fogslin/music-glasses/shots/docs_wiring.png

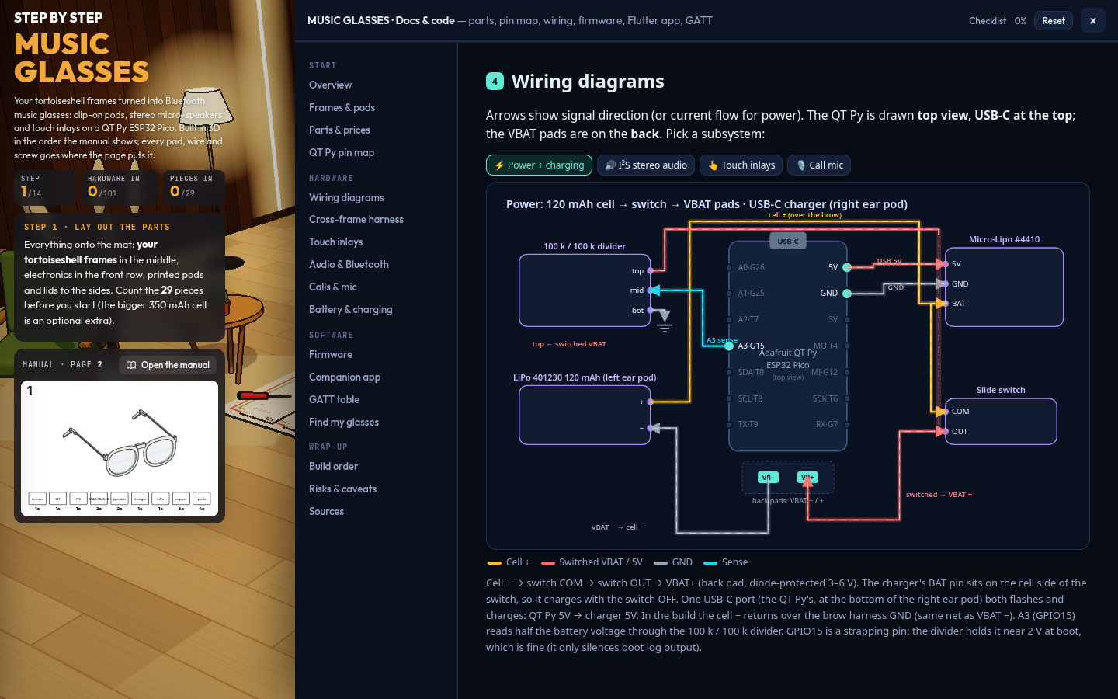
shots/docs_wiring.png
