fogslin/music-glasses/shots/20_soldering.png

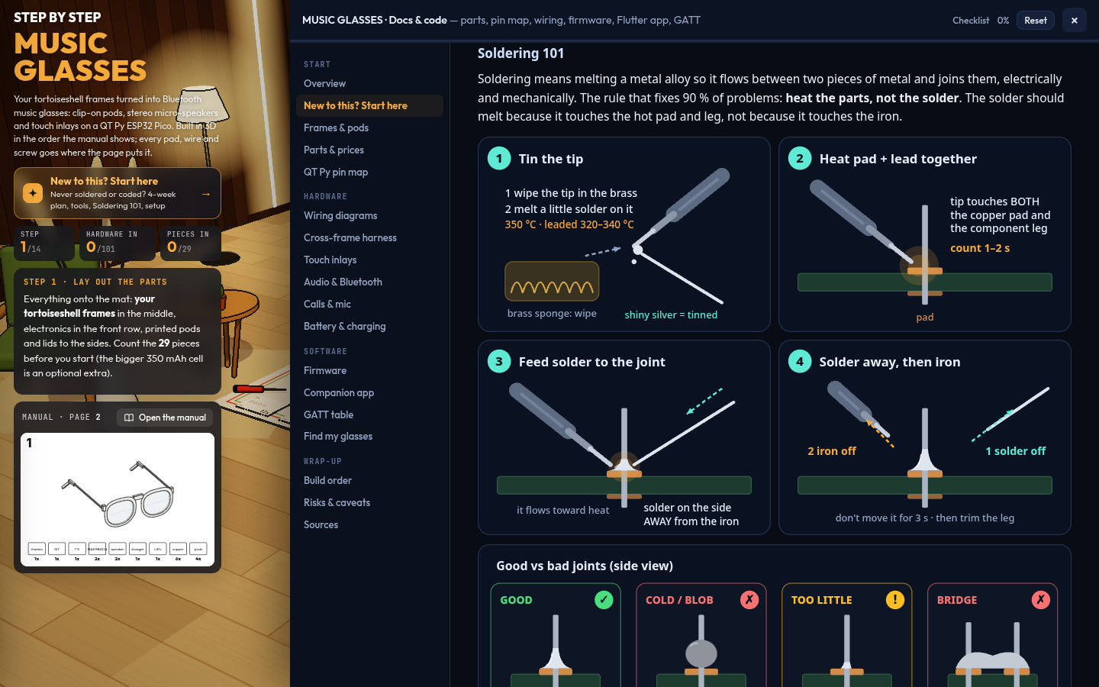
shots/20_soldering.png
