fogslin/music-glasses/shots/01_frames_prep.png

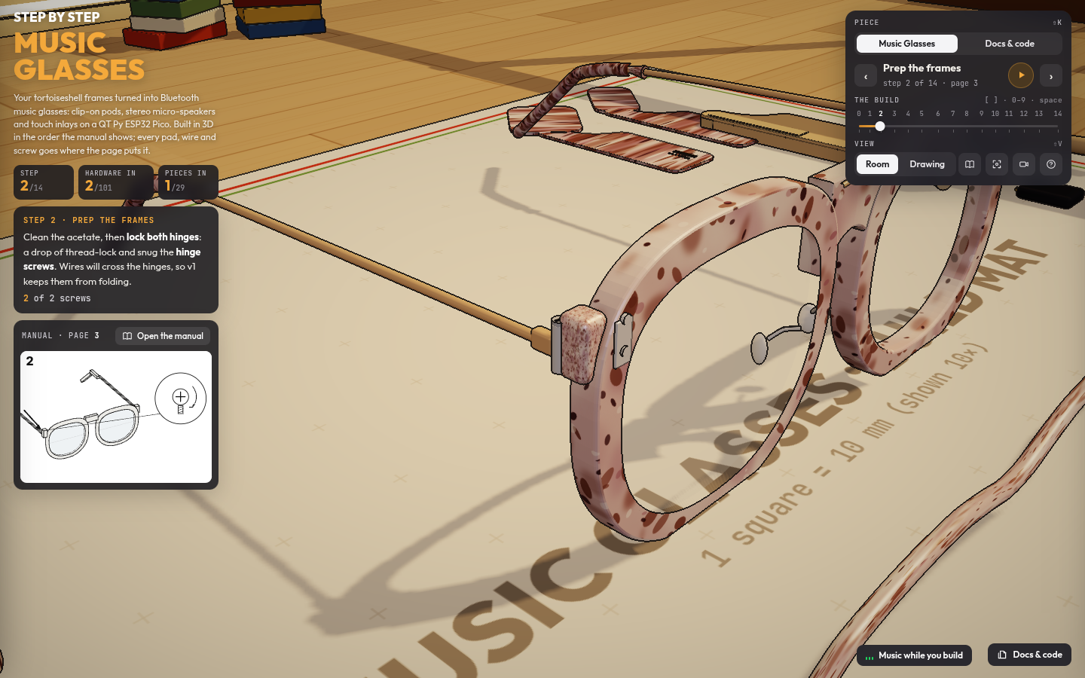
shots/01_frames_prep.png
