fogslin/music-glasses/shots/02_pods_clip.png

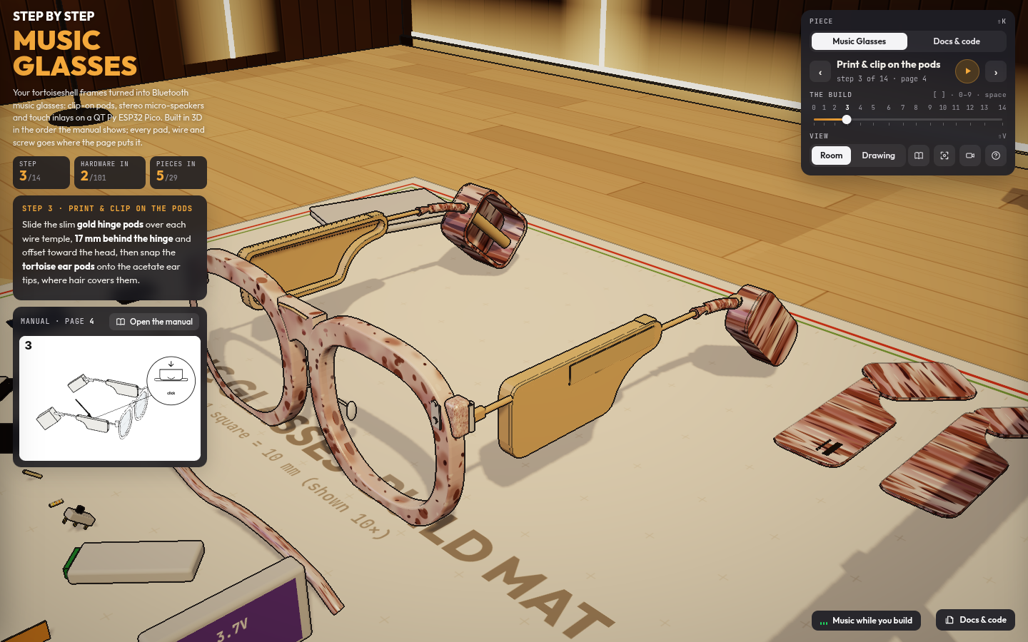
shots/02_pods_clip.png
