fogslin/music-glasses/shots/03_mcu.png

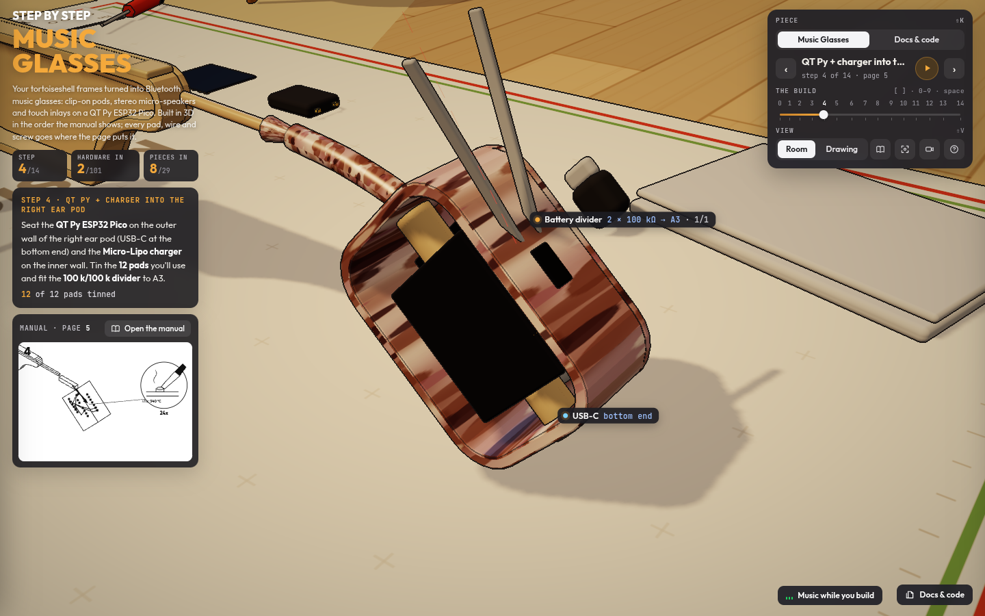
shots/03_mcu.png
