fogslin/music-glasses/shots/04_audio.png

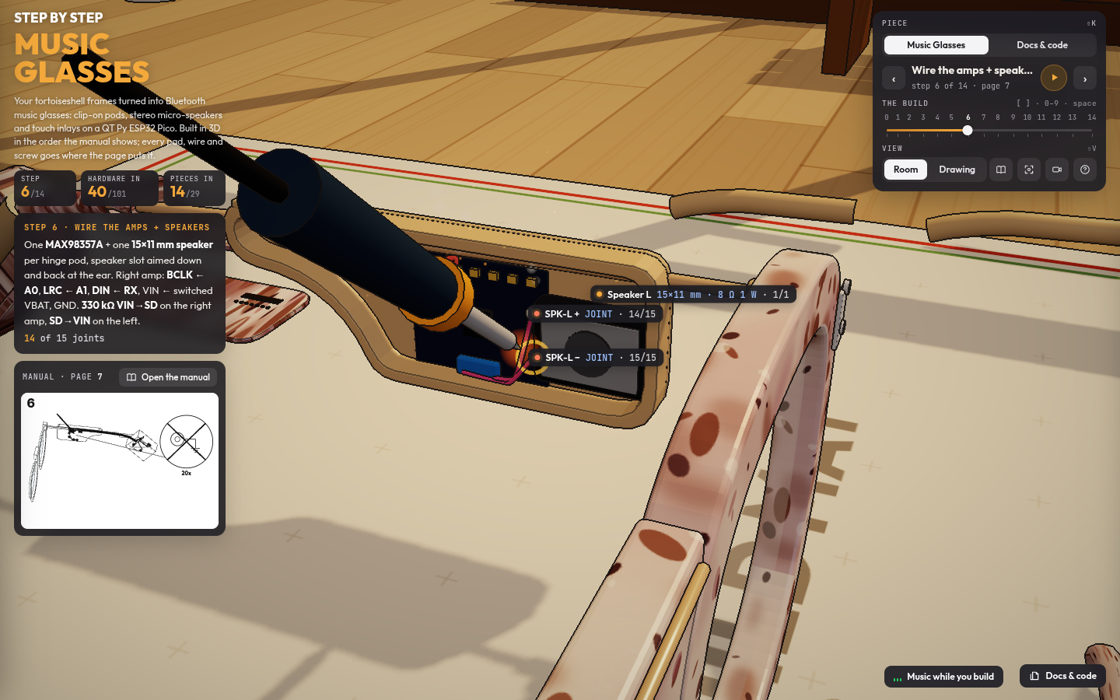
shots/04_audio.png
