fogslin/music-glasses/shots/05_touch.png

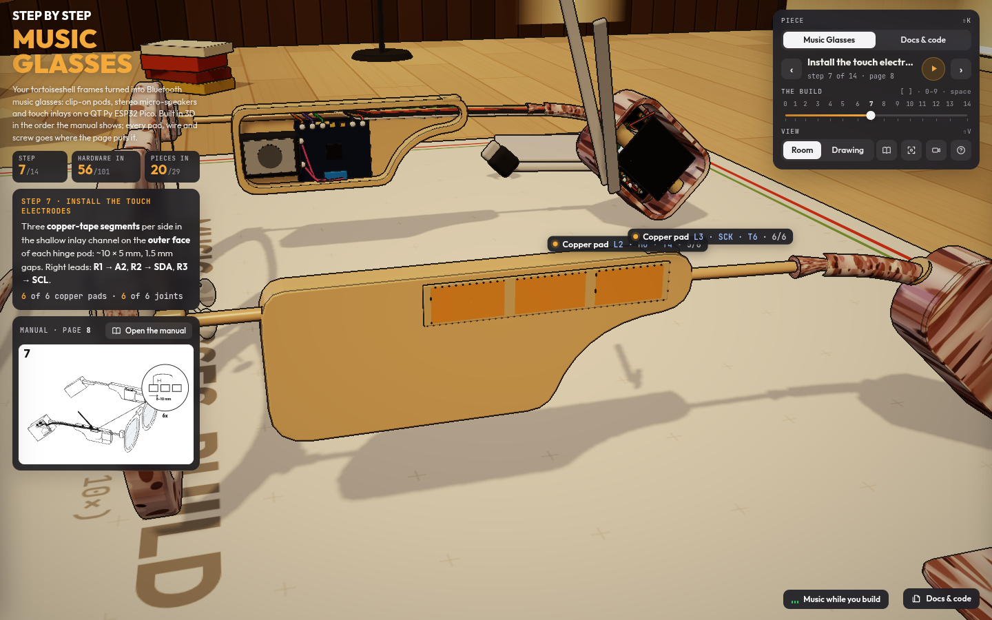
shots/05_touch.png
