fogslin/music-glasses/shots/06_brow.png

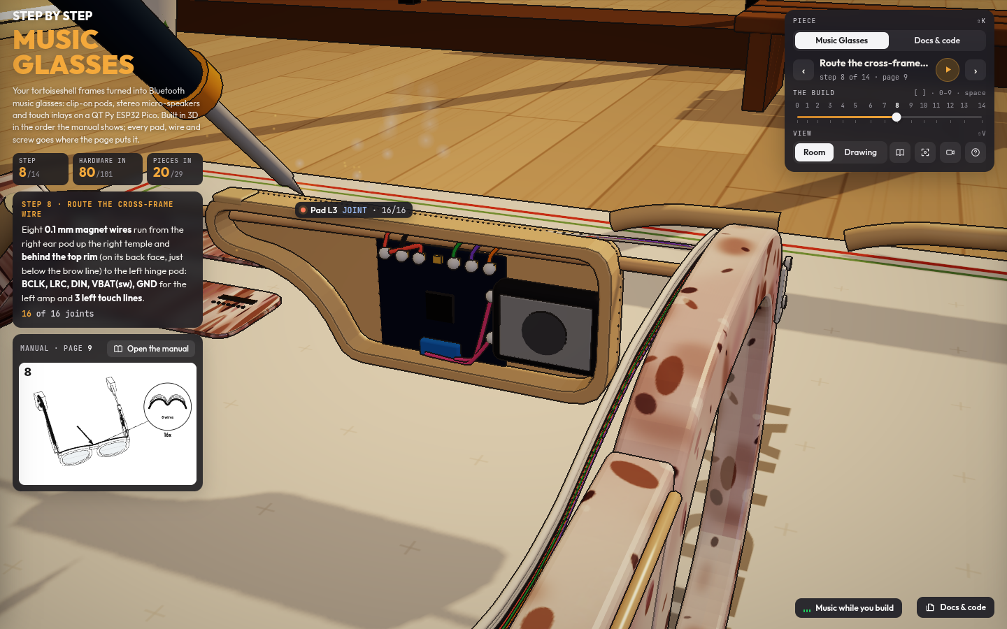
shots/06_brow.png
