fogslin/music-glasses/shots/08_close.png

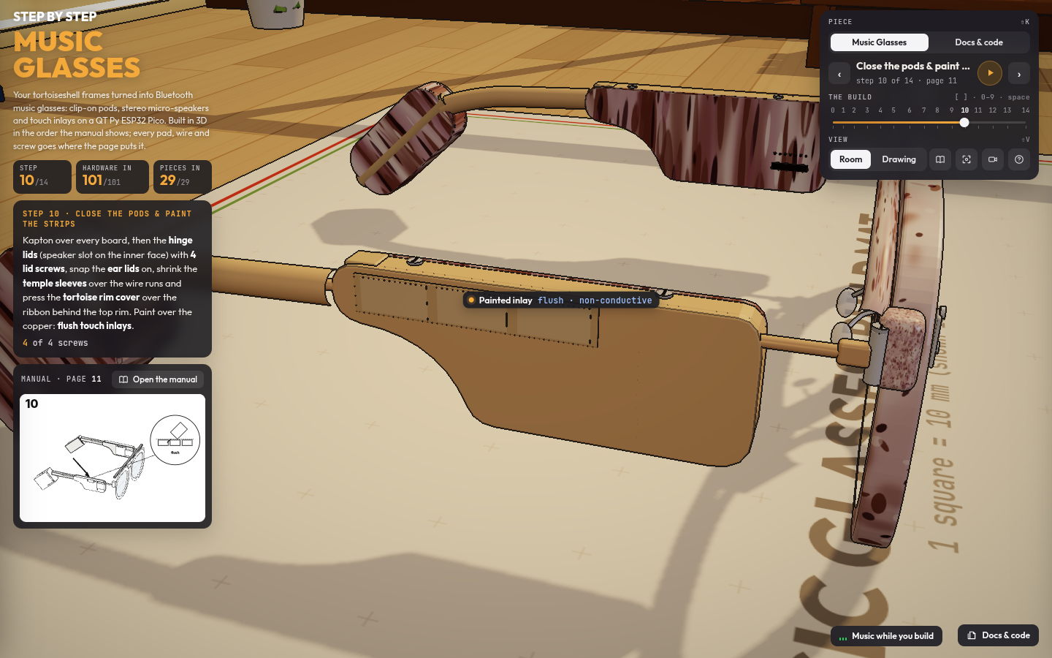
shots/08_close.png
