fogslin/music-glasses/shots/09_flash.png

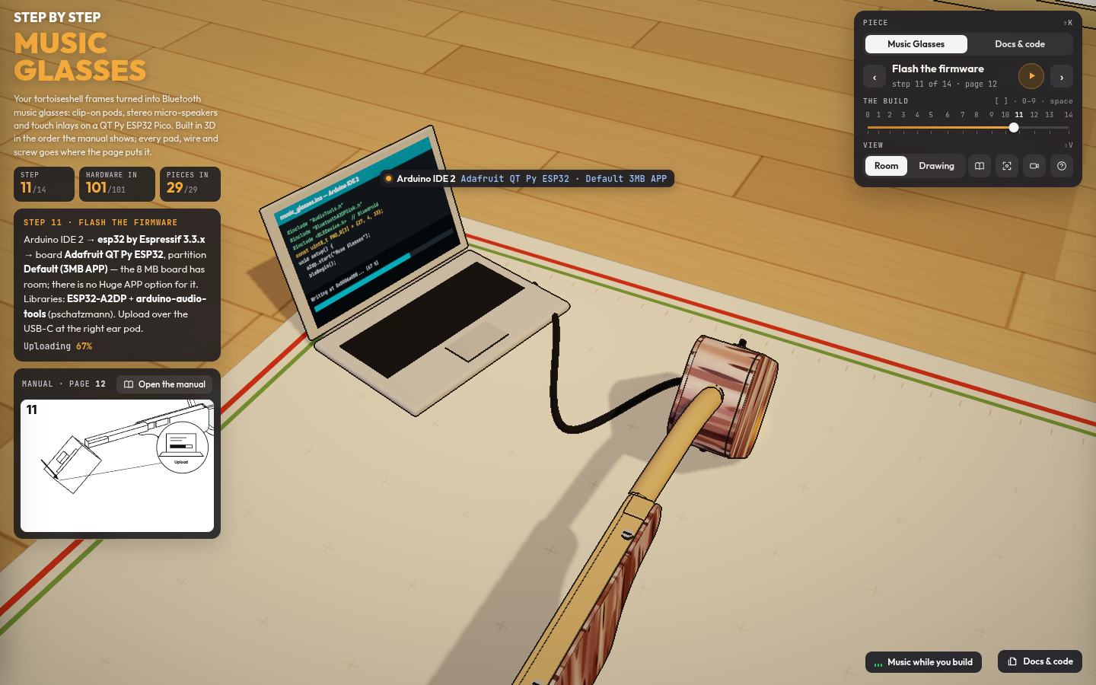
shots/09_flash.png
