fogslin/music-glasses/shots/10_pair_music.png

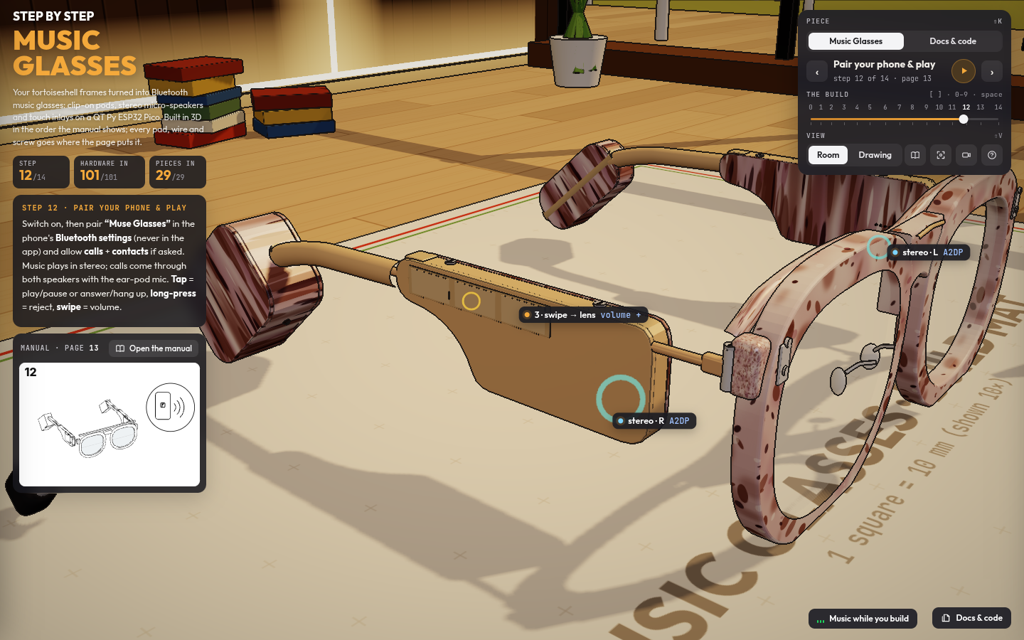
shots/10_pair_music.png
