fogslin/music-glasses/shots/11_app.png

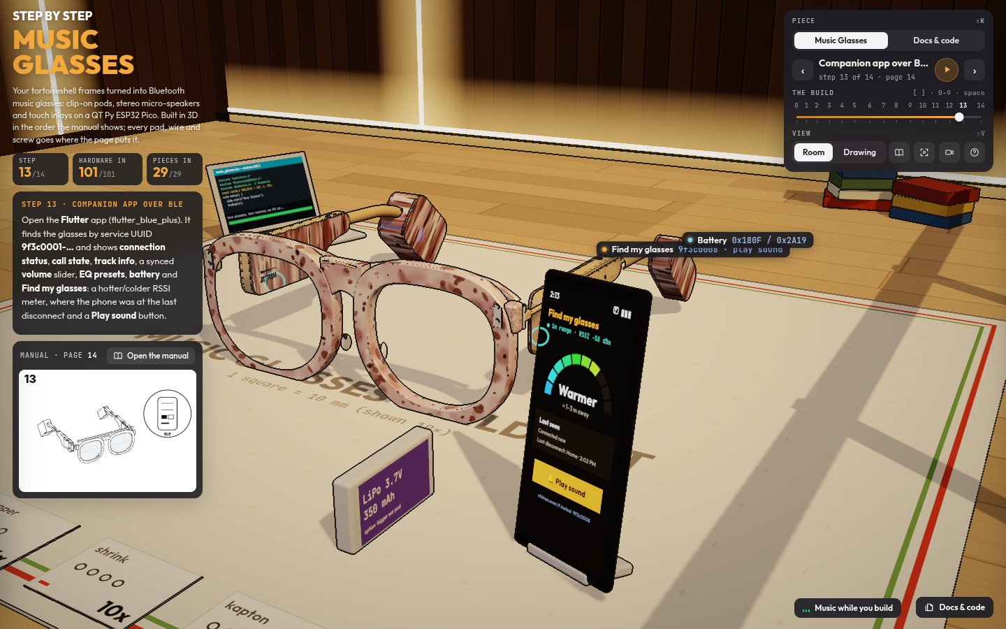
shots/11_app.png
