fogslin/music-glasses/shots/12_final.png

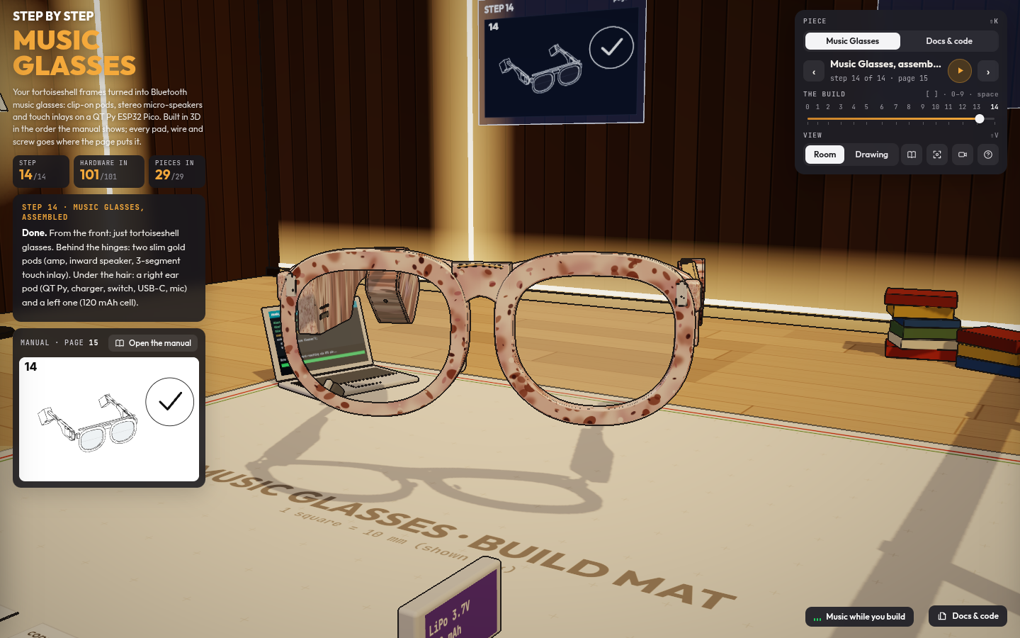
shots/12_final.png
