fogslin/music-glasses/shots/12b_final_turn.png

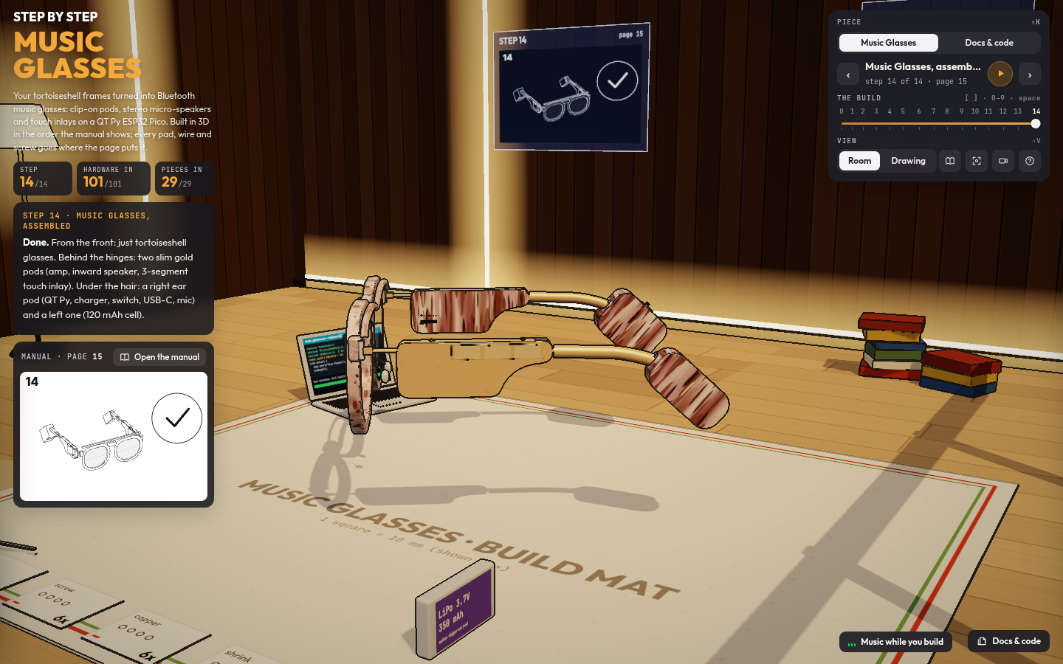
shots/12b_final_turn.png
