fogslin/music-glasses/shots/13_layout.png

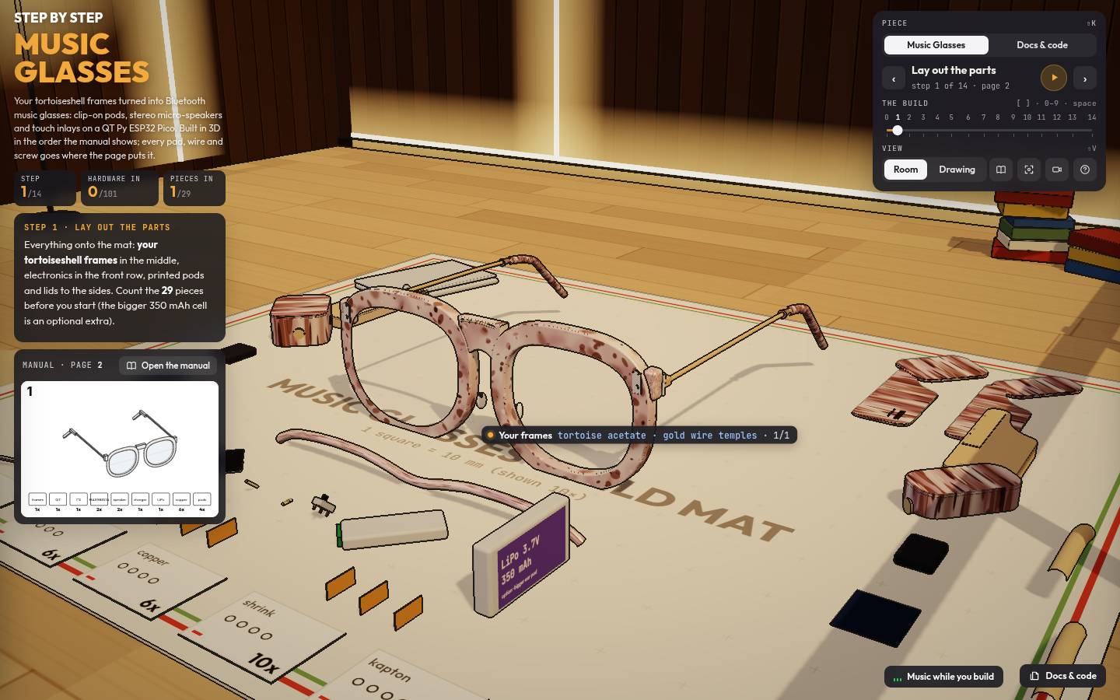
shots/13_layout.png
