fogslin/music-glasses/shots/14_touch_drawing.png

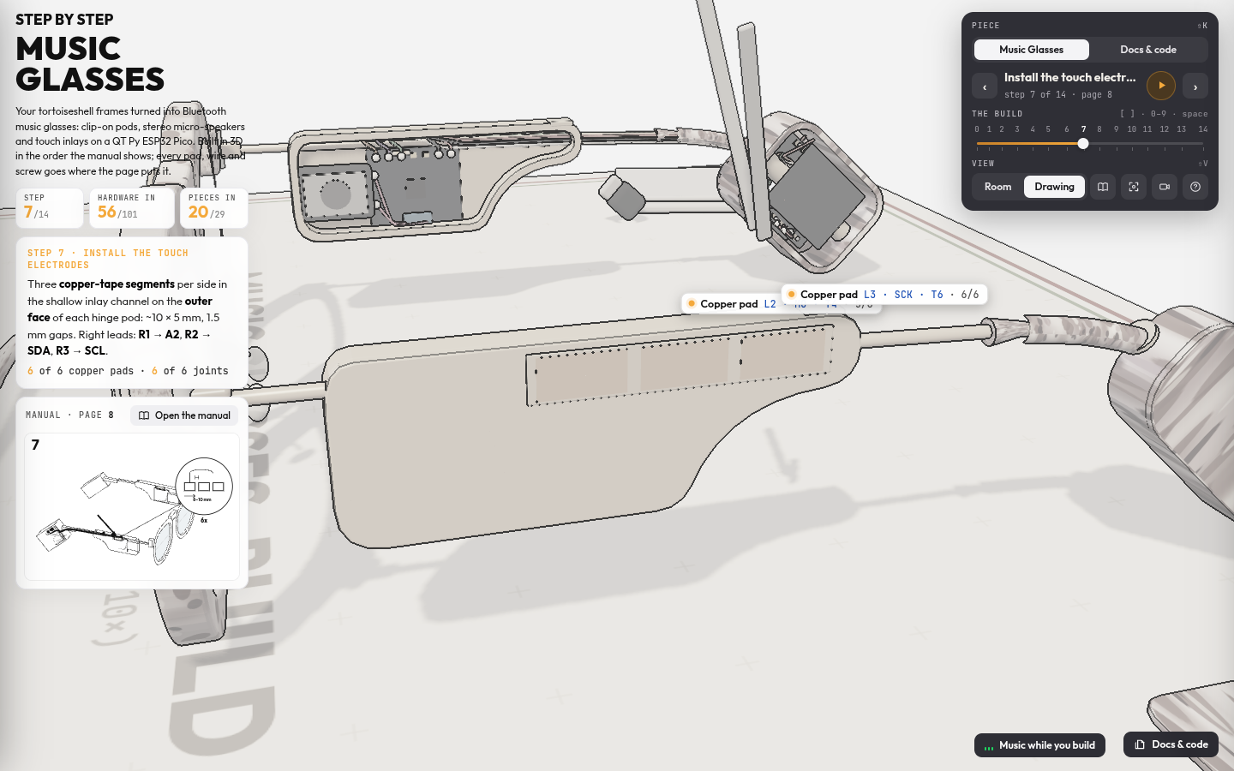
shots/14_touch_drawing.png
