fogslin/music-glasses/shots/15_music_panel.png

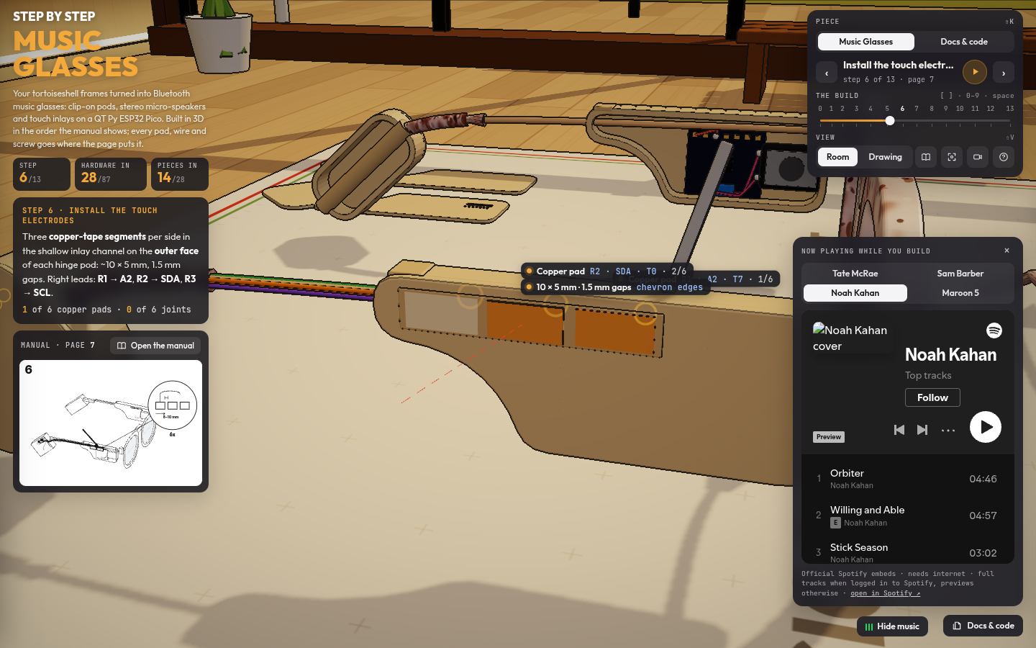
shots/15_music_panel.png
