fogslin/music-glasses/shots/16_mic.png

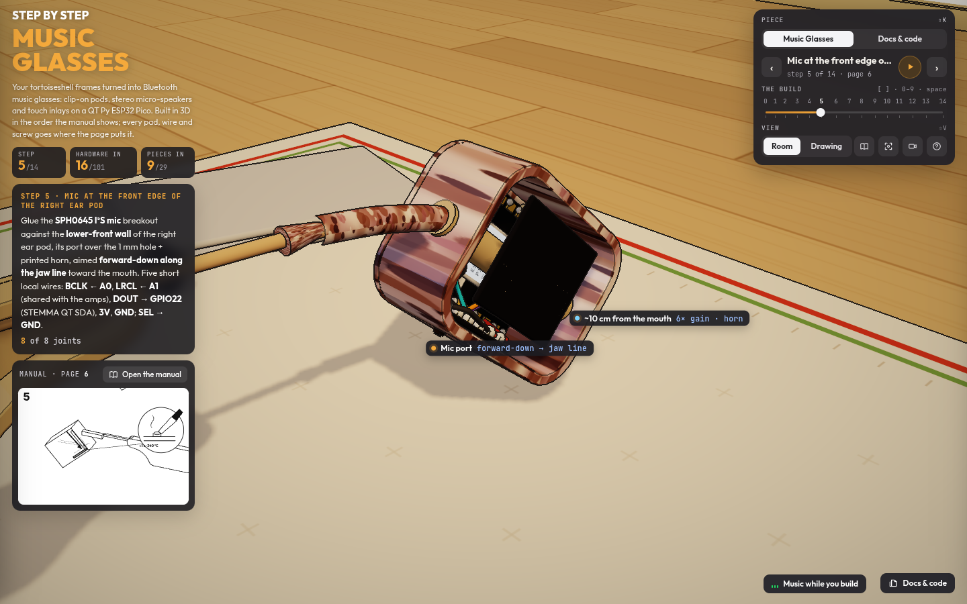
shots/16_mic.png
