fogslin/music-glasses/shots/17_find.png

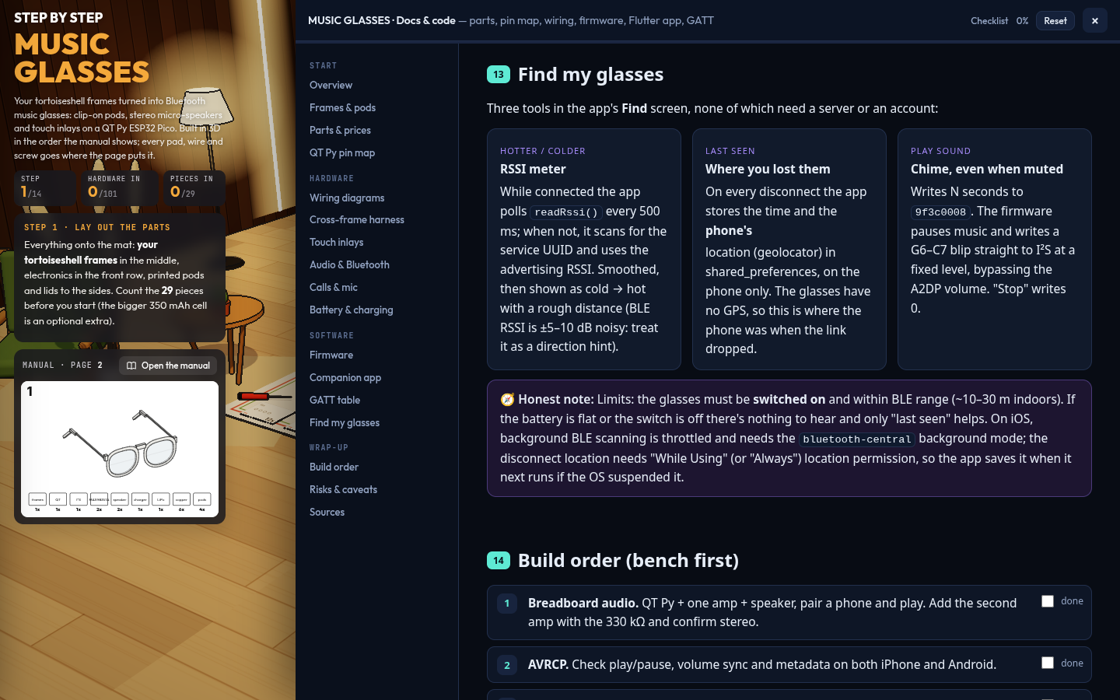
shots/17_find.png
