fogslin/music-glasses/shots/18_front_inconspicuous.png

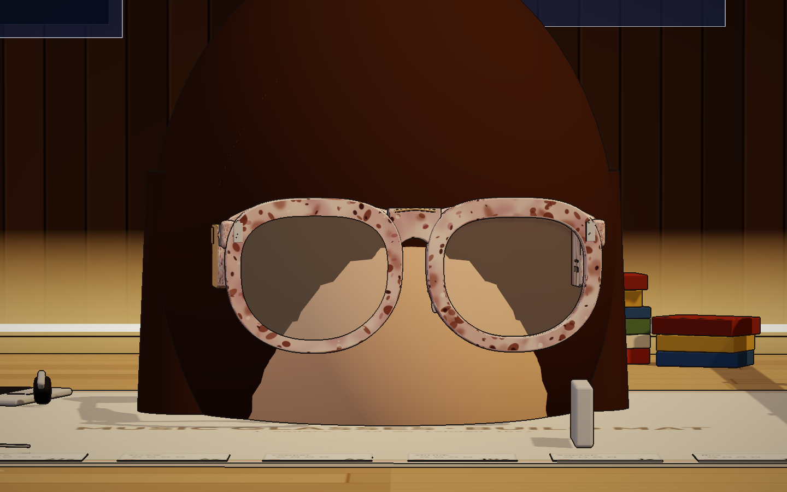
shots/18_front_inconspicuous.png
