fogslin/music-glasses/shots/19_beginner.png

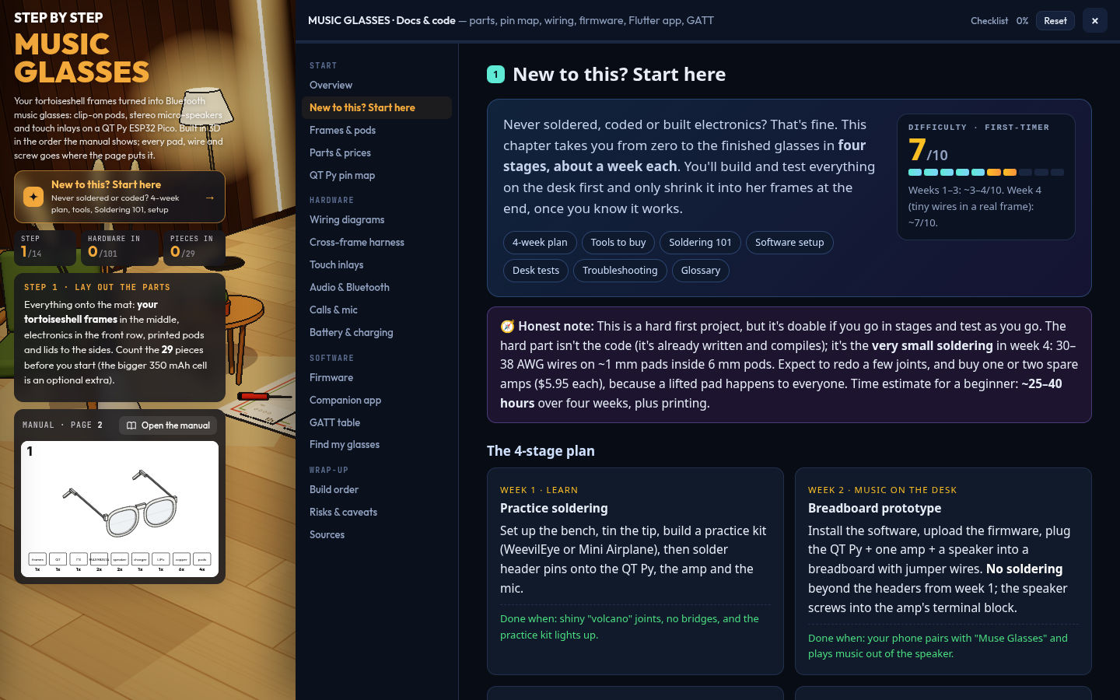
shots/19_beginner.png
