fogslin/music-glasses/build-guide.html

LOADING THE ROOM…

STEP BY STEP

# MUSIC GLASSES

Your tortoiseshell frames turned into Bluetooth music glasses: clip-on pods, stereo micro-speakers and touch inlays on a QT Py ESP32 Pico. Built in 3D in the order the manual shows; every pad, wire and screw goes where the page puts it.

✦New to this? Start hereNever soldered or coded? 4-week plan, tools, Soldering 101, setup→

Step1/13

Hardware in0/0

Pieces in0/0

▾

STEP 1

MANUAL · PAGE 2 Open the manual

PIECE⇧K

Music GlassesDocs & code

‹

…

›

THE BUILD[ ] · 0–9 · space

VIEW⇧V

RoomDrawing

× How it works
The build plays on its own, step after step. Scrub THE BUILD timeline or click a number to jump.
← → / [ ] step · space play/pause · 1–9 jump · M manual · ⇧V Room/Drawing · ⇧K Docs
Drag the scene to look around (free camera); the camera icon toggles it, the frame icon returns to the director.

NOW PLAYING WHILE YOU BUILD×

Official Spotify embeds · needs internet · full tracks when logged in to Spotify, previews otherwise · open in Spotify ↗

Music while you build

Docs & code

MUSIC GLASSES · ASSEMBLY MANUALStep-by-step pages

follow the build ×

‹1 / 1›

MUSIC GLASSES · Docs & code — parts, pin map, wiring, firmware, Flutter app, GATT

Checklist 0%Reset×

Build guide · v1 prototype · from the "Music Glasses v1 Prototype" spec

# Music Glasses Mark 1 — music and calls in your own tortoiseshell frames

Rounded-square tortoiseshell acetate frames that look completely normal from the front. Two slim gold hinge pods sit 17 mm back on the wire temples, each holding a MAX98357A I²S amp, a 15 × 11 mm micro-speaker on the inner face and three flush touch inlays. Two tortoise ear pods ride on the acetate ear tips, under the hair: the right one carries an Adafruit QT Py ESP32 Pico (classic Bluetooth A2DP + HFP + BLE), the USB-C charger, the power switch and an SPH0645 I²S mic at its front edge, aimed down the jaw line; the left one carries a 120 mAh cell. A Flutter app talks to the glasses over BLE and helps you find them.

1 · MusicBluetooth musicA2DP sink "Muse Glasses" + AVRCP: stereo from your phone, one amp + speaker per side.

2 · CallsPhone callsHands-Free Profile (HFP 1.7 client): CVSD 8 kHz or mSBC 16 kHz wideband, mic in the right ear pod.

3 · TouchTap · long-press · swipeTap = play/pause or answer/hang up. Long-press = reject. Swipe = volume (call volume in a call).

4 · AppCompanion appFlutter + flutter_blue_plus: now playing, call state, volume, EQ, battery, settings.

5 · FindFind my glassesHotter/colder RSSI meter, where your phone was at the last disconnect, and a Play-sound chime that ignores mute.

6 · DiscreetInvisible from the frontNothing on the frame front; the cross-frame wire hides behind the top rim; the electronics hide under the hair.

Never soldered, coded or built electronics? Start with New to this? Start here: a 4-week plan, the tools to buy, Soldering 101, software setup from zero and desk tests for every stage.

Hobby prototype. Estimates: ~1 hour of music or ~45–60 min of calls from the 120 mAh cell (~3× with the 350 mAh option). Open-ear sound leaks a little. The mic sits ~10 cm from the mouth (behind the ear, for looks), so callers hear you a bit quieter and with more room sound than on earbuds. The firmware compiles but has not been run on hardware yet.

## 1 New to this? Start here

Never soldered, coded or built electronics? That's fine. This chapter takes you from zero to the finished glasses in four stages, about a week each. You'll build and test everything on the desk first and only shrink it into her frames at the end, once you know it works.

4-week planTools to buySoldering 101Software setupDesk testsTroubleshootingGlossary

DIFFICULTY · FIRST-TIMER

7/10

Weeks 1–3: ~3–4/10. Week 4 (tiny wires in a real frame): ~7/10.

This is a hard first project, but it's doable if you go in stages and test as you go. The hard part isn't the code (it's already written and compiles); it's the very small soldering in week 4: 30–38 AWG wires on ~1 mm pads inside 6 mm pods. Expect to redo a few joints, and buy one or two spare amps ($5.95 each), because a lifted pad happens to everyone. Time estimate for a beginner: ~25–40 hours over four weeks, plus printing.

### The 4-stage plan

Week 1 · LearnPractice solderingSet up the bench, tin the tip, build a practice kit (WeevilEye or Mini Airplane), then solder header pins onto the QT Py, the amp and the mic.

Done when: shiny "volcano" joints, no bridges, and the practice kit lights up.

Week 2 · Music on the deskBreadboard prototypeInstall the software, upload the firmware, plug the QT Py + one amp + a speaker into a breadboard with jumper wires. No soldering beyond the headers from week 1; the speaker screws into the amp's terminal block.

Done when: your phone pairs with "Muse Glasses" and plays music out of the speaker.

Week 3 · Touch & callsStill on the deskAdd three foil/copper-tape touch pads on jumper wires (tap = play/pause, swipe = volume), then the SPH0645 mic (its data wire uses the solderless STEMMA QT cable) and make a real phone call.

Done when: tap pauses, swipe changes volume, a caller can hear you and you can hear them.

Week 4 · ShrinkInto her framesPrint the pods, practise magnet wire on scrap, then follow the 14 animated steps of this guide: amps + speakers in the hinge pods, the hidden harness behind the top rim, touch inlays, then the battery last.

Done when: everything from weeks 2–3 still works with the battery, and nothing shows from the front.

### Tools shopping list

Prices checked Oct 26, 2026 (ET); every link loaded (HTTP 200) that day. USD before tax and shipping; "~" means an estimate. Stock changes daily. These are tools; the glasses' own electronics are in Parts & prices. Essentials ≈ $198, or ≈ $163 if you already own a 45 W+ USB-C laptop charger and cable.

Tool · why | Pick | Price | Link
needSoldering iron, temperature-controlled Melts solder. Temperature control matters: too hot lifts tiny pads, too cold makes dull joints. | Pinecil V2 (USB-C, 12–20 V PD). Comes with a general-purpose tip. | $25.99 | PINE64 store (https://pine64.com/product/pinecil-smart-mini-portable-soldering-iron/) · US stock: SparkFun $68.50 (https://www.sparkfun.com/pinecil-smart-mini-portable-soldering-iron.html)
needUSB-C PD power supply, 45 W+ (65 W best) The Pinecil needs USB-C Power Delivery at 12–20 V, 3 A. A phone charger isn't enough; a 45 W+ laptop charger is fine. | PinePower 65 W GaN charger (skip it if you own a 45 W+ USB-C laptop charger) | $24.99 | PINE64 store (https://pine64.com/product/pinepower-65w-gan-2c1a-charger-with-international-plugs/)
needUSB-C to USB-C cable (5 A, e-marked) Carries the power from the charger to the Pinecil. | Adafruit USB-C to USB-C cable, 1 m | $9.95 | Adafruit #4199 (https://www.adafruit.com/product/4199)
niceFine tips for the iron A fine conical tip makes 30–38 AWG wires and 1 mm pads (week 4) much easier. | Pinecil fine tip set (TS-BC2, TS-C1, TS-ILS, TS-KU) | $24.99 | PINE64 store (https://pine64.com/product/pinecil-soldering-tip-set-fine/)
needSolder, rosin-core, 0.5 mm Thin solder is easier to dose on small joints. Leaded 60/40 melts lower and flows more easily (best for learning); lead-free is the alternative. | 60/40 rosin core 0.5 mm, 50 g | $9.25 | Adafruit #1886 (https://www.adafruit.com/product/1886) · lead-free SAC305: #1930 $27.50 (https://www.adafruit.com/product/1930)
needFlux pen Cleans the metal while you solder so the solder flows. The #1 fix for blobs. | Chip Quik no-clean flux pen CQ4LF, 10 ml | $7.95 | Adafruit #3468 (https://www.adafruit.com/product/3468) · SparkFun $8.50 (https://www.sparkfun.com/chip-quik-no-clean-flux-pen-10ml.html)
needBrass tip cleaner Wipes old solder off the tip without cooling it (better than a wet sponge). | Hakko brass sponge | $10.95 | Adafruit #1172 (https://www.adafruit.com/product/1172) · SparkFun $10.95 (https://www.sparkfun.com/brass-sponge.html)
needIron stand Somewhere safe to put a 350 °C iron down. The Pinecil has no stand of its own. | SparkFun soldering iron stand | $7.75 | SparkFun (https://www.sparkfun.com/soldering-iron-stand.html)
needHelping hands / PCB holder Holds the board or wire so both your hands are free (one for the iron, one for the solder). | Helping third hand with magnifier | $6.95 | Adafruit #291 (https://www.adafruit.com/product/291) · sturdier: PCB holder SN-390 $19.95 (https://www.adafruit.com/product/3791)
needFlush cutters Snip component legs and wires flat. | Flush diagonal cutters CHP170 | $7.25 | Adafruit #152 (https://www.adafruit.com/product/152)
needWire strippers down to 30 AWG Strips the thin silicone wire without cutting the strands. | Hakko CSP-30-1 (20–30 AWG) | $17.50 | Adafruit #527 (https://www.adafruit.com/product/527)
needFine tweezers Hold tiny wires and parts in place (fingers get burned). | Fine-tip curved tweezers, ESD-safe | $3.95 | Adafruit #422 (https://www.adafruit.com/product/422)
needMultimeter Beeps when two points are connected (continuity), measures battery voltage, finds shorts. | SparkFun Digital Multimeter – Basic | $21.50 | SparkFun (https://www.sparkfun.com/digital-multimeter-basic.html) · Adafruit 9205B+ #2034 $17.50 (https://www.adafruit.com/product/2034) out of stock Oct 26
needBreadboard Push-in prototyping board: build the circuit on the desk with no soldering. | Full-size breadboard, 830 points | $5.95 | Adafruit #239 (https://www.adafruit.com/product/239)
needJumper wires (male/male) Plug-in wires for the breadboard. | Premium M/M jumpers, 40 × 150 mm | $3.95 | Adafruit #758 (https://www.adafruit.com/product/758)
needHeader pins Spare pin strips (the QT Py ships without headers; the amp and mic come with a short piece). | 36-pin male header strips, 10 pack | $4.95 | Adafruit #392 (https://www.adafruit.com/product/392)
needSTEMMA QT → male jumper cable Reaches the mic data pin (GPIO22 on the QT Py's little connector) with no soldering. | STEMMA QT / Qwiic to male headers, 150 mm | $0.95 | Adafruit #4209 (https://www.adafruit.com/product/4209)
needUSB data cable for the QT Py Many cheap cables only charge. This one carries data. (The C-to-C cable above also works if your computer has USB-C.) | USB-A to USB-C, 1 m | $4.95 | Adafruit #4474 (https://www.adafruit.com/product/4474)
needBeginner practice kit ($10–20) Through-hole practice before you touch the real parts. Pick one. | SparkFun WeevilEye (10–20 min build) | $9.95 | SparkFun (https://www.sparkfun.com/sparkfun-weevileye-beginner-soldering-kit.html) · Mini Airplane kit $14.95 (https://www.sparkfun.com/mini-airplane-soldering-kit-red.html)
needSafety glasses Clipped legs and solder spatter fly. Always wear them. | SparkFun safety glasses | $5.10 | SparkFun (https://www.sparkfun.com/sparkfun-safety-glasses.html)
needSolder wick (desoldering braid) Soaks up solder to fix bridges and mistakes. | Solder wick, 0.8 mm × 1.5 m | $2.95 | Adafruit #4456 (https://www.adafruit.com/product/4456) · 1.5 mm: #149 $3.50 (https://www.adafruit.com/product/149)
needKapton (polyimide) tape Heat-proof insulating tape: covers joints and protects the frame near the iron. | Polyimide tape, 1 cm × 33 m | $4.95 | Adafruit #3057 (https://www.adafruit.com/product/3057)
needFume extraction / ventilation Rosin smoke irritates eyes and lungs. Work by an open window with a small fan pulling the smoke away from your face (not blowing it at you). | Window + any small desk fan | ~$0–20 (estimate) | no link: use what you have · bench extractor: Hakko FA-400 $81.67 (https://hakkousa.com/products/fume-extraction.html)
niceDesk test speaker A bigger, louder speaker for the week 2 breadboard (the tiny glasses speakers work too). | Speaker 3", 4 Ω 3 W | $1.95 | Adafruit #1314 (https://www.adafruit.com/product/1314)

The Pinecil from the PINE64 store ships from overseas (slow). SparkFun's listing is pricier but ships from the US. Any temperature-controlled iron with a fine tip works, e.g. the ATTEN ST-2065D, $37.50 (https://www.adafruit.com/product/4695) out of stock Oct 26.

### Soldering 101

Soldering means melting a metal alloy so it flows between two pieces of metal and joins them, electrically and mechanically. The rule that fixes 90 % of problems: heat the parts, not the solder. The solder should melt because it touches the hot pad and leg, not because it touches the iron.

1. Set up. Safety glasses on, window open, fan pulling the smoke away. Iron in its stand, brass cleaner next to it. Set 330 °C for leaded solder (350–370 °C for lead-free).
2. Tin the tip (fig. 1). Wipe it in the brass, then melt a little solder onto it. A shiny tip moves heat; a black, dull one doesn't. Re-tin before you put the iron back in the stand.
3. Make a joint (figs. 2–4). Touch the tip to the pad and the leg for 1–2 s, feed solder into the far side of the joint until it forms a small cone, take the solder away, then the iron. 2–4 s in total. Don't blow on it or move it while it sets.
4. Practice kit. Build the WeevilEye or Mini Airplane. Compare every joint with the good-vs-bad picture, fix the bad ones with flux + reheat or wick (fig. 8).
5. Headers on the real boards. Push the header strip into the breadboard (long pins down), drop the QT Py on top, solder one corner pin, check it's straight, then do the rest. Same for the amp's and the mic's headers. The breadboard keeps the pins straight.
6. Thin wire (figs. 5–6). Strip 2–3 mm of 30 AWG, twist, flux, tin. Tin the pad, lay the wire on, hold it with tweezers, touch 1 s. Tug gently: a good joint doesn't move.
7. Magnet wire (fig. 7, week 4). Practise 10 times on scrap wire before the real harness. Burn the enamel off in a hot solder blob, or scrape it. Then beep it with the multimeter.

Safety. The tip is ~350 °C: always put the iron back in its stand, never on the desk, and never catch a falling iron. Run cool water over a burn for 10–20 min. Ventilate (the smoke is flux, not lead, but it irritates). Wash your hands after soldering and before eating, especially with leaded solder; don't eat or drink at the bench. LiPo batteries: never short the two leads (cut and insulate one wire at a time), never puncture, bend or squeeze the cell, never charge it unattended or above 4.2 V, use only a protected cell and the 100 mA charger, and don't charge while wearing. If a cell swells, gets hot or smells sweet, stop using it and put it on a non-flammable surface outdoors.

### Software setup from zero

The firmware is the program that runs on the QT Py. You'll install a free editor, teach it about ESP32 boards, add two libraries, then press Upload. It takes about 30–45 minutes the first time, mostly downloads.

1. Install Arduino IDE 2. Download it from arduino.cc/en/software (Windows, macOS or Linux) and open it.
2. Add the ESP32 boards URL. File → Preferences (macOS: Arduino IDE → Settings) → Additional boards manager URLs, paste: https://espressif.github.io/arduino-esp32/package_esp32_index.json → OK. (Espressif's install guide (https://docs.espressif.com/projects/arduino-esp32/en/latest/installing.html))
3. Install the esp32 core. Tools → Board → Boards Manager, search esp32, pick esp32 by Espressif Systems, choose version 3.3.x (tested: 3.3.12) and Install. It's a big download (~10 min).
4. Select the board. Tools → Board → esp32 → Adafruit QT Py ESP32 (that's the Pico). Leave Partition Scheme on the default (3 MB app). (Adafruit's setup page (https://learn.adafruit.com/adafruit-qt-py-esp32-pico/arduino-ide-setup))
5. Install the two libraries (GitHub zips). Download ESP32-A2DP v1.8.11 .zip (https://github.com/pschatzmann/ESP32-A2DP/archive/refs/tags/v1.8.11.zip) and arduino-audio-tools v1.2.6 .zip (https://github.com/pschatzmann/arduino-audio-tools/archive/refs/tags/v1.2.6.zip). In the IDE: Sketch → Include Library → Add .ZIP Library… and pick each zip in turn. Don't unzip them first.
6. Open the sketch. Unzip this project, then File → Open → firmware/music_glasses/music_glasses.ino (the folder name must match the file name, as it does here).
7. Plug in USB-C. Use a data cable. Tools → Port: pick the new entry (Windows COM3…, macOS /dev/cu.usbserial-…, cu.usbmodem… or cu.wchusbserial…, Linux /dev/ttyACM0 or ttyUSB0).
8. Upload. Click the → arrow. It compiles (1–3 min the first time), then shows Writing at 0x… percentages and Hard resetting via RTS pin…. Done.
9. Read the Serial Monitor. Tools → Serial Monitor, set 115200 baud, press the QT Py's RST button. You should see Muse Glasses ready, free heap ….

#### Common errors

What you see | Why | Fix
No port in Tools → Port, or it's greyed out | Charge-only USB cable, or a missing USB-serial driver. Recent QT Py ESP32 Picos use a WCH CH9102F chip (older ones a CP2102N). | Try a different cable that you know carries data. Install the WCH driver (Adafruit's CH9102 driver guide (https://learn.adafruit.com/how-to-install-drivers-for-wch-usb-to-serial-chips-ch9102f-ch9102)), then unplug/replug. Linux: add yourself to the dialout group and log out/in.
Failed to connect to ESP32: No serial data received / Wrong boot mode | The board didn't enter upload mode on its own. | Hold BOOT, tap RST, release BOOT, click Upload again. Press RST after it finishes.
BluetoothA2DPSink.h: No such file or directory or AudioTools.h: No such file… | Library missing or added wrongly. | Re-add the right zip with Add .ZIP Library… and restart the IDE. Check Sketch → Include Library lists ESP32-A2DP and audio-tools.
esp_hf_client_api.h not found / errors about esp_a2d_… | Wrong board or an old core. | Board must be an ESP32 one (Adafruit QT Py ESP32) on core 3.3.x, not "Arduino Uno".
Sketch too big | Partition scheme changed. | Tools → Partition Scheme → Default (3 MB app). The sketch is ~1.2 MB.
Serial Monitor shows gibberish | Wrong speed. | Set 115200 baud in the monitor's drop-down.
Port busy / access denied | Another program (or a second IDE window) holds the port. | Close other serial monitors, unplug/replug.

### Desk-test checkpoints

Test at every stage before you move on. Tick them off: progress is saved in this browser.

#### Week 1 · bench & practice

1. Iron heats to the set temperature in ~10–20 s on the PD charger (the Pinecil screen shows it). Solder melts instantly on the tinned tip.
2. Practice kit works (the LEDs light). All joints look like the GOOD picture.
3. Multimeter beeps when you touch the two probes together (continuity mode, the ))) symbol). Beep one header pin against its pad: beep. Against the next pin: silence (no bridge).

#### Week 2 · music on the breadboard

1. Upload works and the Serial Monitor says Muse Glasses ready, free heap … (the number should be well above 30000).
2. Wire it with the board unplugged: 5V→VIN, GND→GND, A0→BCLK, A1→LRC, RX→DIN; GAIN and SD unconnected; speaker into the + / − terminal block. Double-check 5V and GND before you plug in.
3. Pair. Phone → Bluetooth → Muse Glasses. Serial: A2DP connected, free heap ….
4. Hear music from the speaker, at a level that follows the phone's volume buttons. Play/pause on the phone works. Some hiss with no music is normal; crackle isn't (see troubleshooting).

#### Week 3 · touch, then mic + calls

Part | Wire on the breadboard | Notes
Touch pads R1 / R2 / R3 | A2 (GPIO27) · SDA (GPIO4) · SCL (GPIO33) → one jumper each → a 1 × 1 cm square of copper tape or foil, three in a row ~2 mm apart, on a piece of card | Front → rear. Don't let the squares touch each other. Press RST after wiring: the firmware measures the untouched pads at start-up.
SPH0645 mic (headers soldered) | 3V → mic 3V · GND → GND · A0 → BCLK · A1 → LRCL · SEL → GND · DOUT → the blue (SDA) wire of the STEMMA QT cable plugged into the QT Py's small connector (GPIO22) | The mic shares BCLK/LRC with the amp: two jumpers in the same breadboard row. Leave the cable's yellow (SCL) wire unconnected.

1. Tap any pad briefly (40–300 ms): music pauses / plays.
2. Swipe a finger across R3→R2→R1 (rear to front, toward the lens): volume up a step. The other way: down.
3. Call. Call your phone from another phone (or call a friend). Tap a pad to answer. Serial: HFP state … then SCO mSBC 16k (or CVSD 8k). You hear the caller from the speaker; they hear you when you talk near the mic.
4. Hang up with a tap; while it's ringing, a ≥ 0.8 s press rejects the call. After the call, music resumes.
5. Optional: the BLE app / nRF Connect sees the glasses' service (see GATT table).

#### Week 4 · in the frames

1. Dry fit the printed pods on her frames and check the front view in a mirror before any soldering.
2. Beep every harness wire end to end and against its neighbours before it goes behind the rim cover.
3. Test on USB first (no battery): pairing, both speakers, touch and a call, exactly like weeks 2–3.
4. Battery last. Check polarity with the meter (red + / black −), switch off, connect, insulate. Switch on: Serial shows the ready line; unplug USB and it keeps playing.

### Troubleshooting checklist

No soundPairs, but silent

- VIN on 5V (not 3V) and GND connected?
- BCLK/LRC/DIN not swapped (A0→BCLK, A1→LRC, RX→DIN)?
- SD not tied to GND (that shuts the amp down)?
- Speaker screws tight on bare wire, not on insulation?
- Phone volume up and "Muse Glasses" picked as the audio output?

BluetoothWon't show up / won't pair

- Serial shows the ready line? If not: re-upload, press RST.
- "Forget" old Muse Glasses on the phone and pair again.
- Only one phone at a time: switch Bluetooth off on the other.
- Keep the board within a few metres while testing.

NoiseCrackle, pops, dropouts

- Push the jumpers fully in; wiggle each one while music plays.
- Use a short USB cable straight into the computer or a wall charger, not a hub.
- Free heap in Serial under ~20000? See Audio & Bluetooth.

TouchRandom pauses or no response

- Press RST with your hands off the pads (it calibrates at start-up).
- Pads not touching each other, jumpers in the right pins (A2, SDA, SCL)?
- Laptop on battery vs charger changes readings: test both.

CallsThey can't hear you

- Mic SEL to GND, 3V (not 5V) to the mic.
- DOUT on the blue STEMMA QT wire (GPIO22).
- BCLK/LRCL shared with the amp's rows.
- Talk within ~10 cm; raise MIC_GAIN in the sketch if quiet.

BoardResets, hot parts, weird smells

- Unplug at once. Look for a solder bridge or a 5V-to-GND jumper.
- Beep 5V against GND with USB unplugged: it must not beep.
- Battery hot or puffy: stop, see the LiPo safety box above.

### Glossary, in plain words

GPIO

"General-purpose input/output": one of the QT Py's metal pins the program can switch on/off or read. GPIO27 = pin number 27 inside the chip (printed "A2" on the board).

Pad

A small copper spot on a board where you solder a wire or a pin.

Header pins

A strip of metal pins you solder onto a board so it can plug into a breadboard.

Breadboard

A plastic board full of holes connected in rows: push parts and jumper wires in, no solder.

Jumper wire

A short wire with a pin on each end, for breadboards.

Microcontroller · QT Py ESP32 Pico

A tiny computer on a chip that runs one program. Ours does the Bluetooth, reads the touch pads and sends sound to the amps.

Firmware · sketch

The program on the microcontroller. In Arduino a program is called a sketch (.ino file).

Library

Ready-made code someone else wrote (here: Bluetooth audio) that our sketch uses.

Core / board package

The add-on that teaches the Arduino IDE how to build programs for ESP32 chips.

Serial Monitor

A window in the Arduino IDE that shows text messages the board sends over USB. Your best debugging tool.

Bluetooth Classic vs BLE

Classic Bluetooth carries the audio (music and calls). BLE (Bluetooth Low Energy) is a low-power side channel the app uses for buttons, battery and Find my glasses.

A2DP

The Bluetooth "profile" for streaming music in stereo from your phone.

AVRCP

The profile for remote control: play, pause, volume, song titles.

HFP

Hands-Free Profile: phone calls (voice both ways, answer/hang up).

I²S

"Inter-IC Sound": a 3-wire digital audio connection (bit clock BCLK, left/right clock LRC, data DIN/DOUT) between the QT Py and the amps/mic.

Amp · MAX98357A

Turns the digital I²S audio into a signal strong enough to drive a speaker.

MEMS mic · SPH0645

A tiny digital microphone chip that outputs I²S.

LiPo

Lithium-polymer battery: light and small, but must never be shorted, punctured or overcharged (max 4.2 V).

Flux

A cleaning chemical (built into rosin-core solder, extra from the pen) that lets solder flow and stick.

Rosin-core solder

Solder wire with flux inside. 60/40 = 60 % tin, 40 % lead. Lead-free (SAC305) needs a hotter iron.

Tinning

Coating a tip, wire or pad with a thin layer of solder first, so the final joint is quick.

Cold joint

A dull, lumpy joint that didn't get hot enough. It may work today and fail tomorrow. Reheat it with flux.

Bridge

Solder accidentally joining two pads that shouldn't touch: a short circuit.

Solder wick

Copper braid that soaks up melted solder to undo mistakes.

AWG

Wire thickness; bigger number = thinner. 30 AWG ≈ 0.25 mm, 38 AWG magnet wire ≈ 0.1 mm (hair-thin).

Magnet wire

Solid copper wire insulated by a thin enamel coating instead of plastic. Used for the hidden harness because it's so thin.

Continuity

Multimeter mode that beeps when two points are electrically connected.

Short circuit

An accidental connection (usually + to −) that lets too much current flow. It can heat parts or a battery fast.

Kapton

Orange heat-proof tape (polyimide) that insulates and protects.

USB-C PD

Power Delivery: lets a USB-C charger give more than 5 V (the Pinecil wants 12–20 V).

Boot mode

A special start-up mode for receiving new firmware (hold BOOT, tap RST).

## 2 Frames & pods

The 3D model follows your frames, not the spec's gold cat-eye donor: a rounded-square / soft-panto front in mottled rose-mauve, cream and brown translucent acetate (lens ≈ 50 × 42 mm, bridge ≈ 19 mm), thick rims, a slim metal bridge accent, silver rivet plates at the outer front corners, metal nose pads, and very thin light-gold wire temples (≈ 140 mm) ending in tortoise acetate ear tips.

Printed part | Size (approx.) | Holds | Notes
Hinge pod ×2 | 59 × 21 × 6.2 mm | MAX98357A + speaker (inner face) + 3 touch pads | Starts 17 mm behind the hinge and is centred 2.2 mm inside the wire, so from the front it hides behind the end piece. Gold mica paint to match the wire temples. Open toward the head, closed by a lid with the speaker slot.
Right ear pod | 32 × 24 × 15 mm | QT Py, Micro-Lipo charger, slide switch, SPH0645 mic | Clamps on the acetate ear tip, behind the ear. USB-C at the bottom end, switch knob on top, mic port + 3 mm horn in the lower-front wall pointing forward-down at the jaw line. Tortoise finish.
Left ear pod | 34 × 16 × 9.5 mm | 120 mAh 401230 cell | Snap-fit lid, tortoise finish. A 350 mAh cell needs a longer pod.
Rim cover strip | ≈ 126 mm arc, Ø 3 mm | 9-wire harness | Tortoise half-round strip glued along the back of the top rim, 2–3 mm below its top edge. Invisible from the front.

### Inconspicuous by design

The wearer's hair covers the temples and ears, so the layout pushes everything that can move back there:

- Frame front: nothing electronic, no wires, no LEDs. The cross-frame ribbon runs on the back face of the top rim, under a tortoise cover strip. Cleaner (but irreversible) option: route a 1 mm groove along the inside top edge of the rim and fill it with tinted UV resin.
- Hinge pods: as slim (6.2 mm) and as far back (17 mm behind the hinge) as the amp breakout allows; outer face flush with the end piece; the head-side lid is tortoise. Speakers fire from the inner face; no grille on show. Gold paint, like the wire temples.
- Behind-ear pods: QT Py, charger, switch, USB-C, battery and the mic. Tortoise, like the ear tips. Hidden by hair.
- What still can't move back: the amps + speakers (they must sit near the ear canal, and moving the amps would add 4 more wires per side down the temple) and the touch pads (where a finger naturally lands).

The hinge pods are taller than the wire temple by design: the amp breakout (19 × 18 mm) sets their height, but from the front they stay inside the end piece's outline. Use a non-conductive finish over the touch pads.

1. Measure your frames. Wire temple diameter (~1.5–1.8 mm), hinge-to-ear-tip distance, ear-tip thickness. Adjust the pod channels before printing.
2. Print. Resin or PLA at 0.12 mm layers. Sand, prime, dry-fit on your head: pods must clear your temples, ear pods sit behind the ears. Look at it face-on in a mirror: nothing should show past the end pieces.
3. Pin the hinges. Wires crossing a folding hinge fatigue fast. For v1 pin the hinges open (thread-lock the hinge screws) or leave a soft silicone-wire loop.

## 3 Parts list (BOM)

Prices come from the Music Glasses v1 spec (USD, before shipping/tax). Lines marked ~ are estimates. You already own the frames, so the donor-frame line is skipped.

Part | Purpose | Qty | Price | Link

### Tools & consumables

Fine-tip temperature-controlled iron, 0.3–0.5 mm rosin-core solder, flux pen, tweezers, flush cutters, multimeter, Kapton tape, UV resin, a hobby knife for the 0.1 mm pad recesses and a 3D printer (or a print service).

## 4 QT Py ESP32 Pico pin map

Verified against Adafruit's QT Py ESP32 Pico pinouts (https://learn.adafruit.com/adafruit-qt-py-esp32-pico/pinouts) and the Arduino-ESP32 variant file. Touch channels are the original ESP32's T0–T9.

Pad | GPIO | Alt | Use | Connects to | Notes

## 5 Wiring diagrams

Arrows show signal direction (or current flow for power). The QT Py is drawn top view, USB-C at the top; the VBAT pads are on the back. Pick a subsystem:

## 6 Cross-frame harness

Everything lives on the right except the left amp, the left touch pads and the cell. The right amp gets its 5 wires straight down the right wire temple; the left side is reached along the back of the top rim, invisible from the front. The spec counts 8 cross-frame wires; this build runs 9, because the cell's + lead from the left ear pod also has to reach the switch in the right ear pod. The mic adds no cross-frame wires: its 5 leads stay inside the right ear pod.

# | Signal | From (right) | To (left) | Wire

1 | BCLK | A0 / GPIO26 | Left amp BCLK | 38 AWG magnet
2 | LRC | A1 / GPIO25 | Left amp LRC | 38 AWG magnet
3 | DIN | RX / GPIO7 | Left amp DIN | 38 AWG magnet
4 | VBAT (switched) | Switch OUT | Left amp VIN (+ SD, GAIN) | 32 AWG silicone
5 | GND | QT Py GND | Left amp GND → cell − | 32 AWG silicone
6–8 | Touch L1 / L2 / L3 | TX / MO / SCK | Left pod pads 1–3 | 38 AWG magnet, keep apart from BCLK
9 | Cell + (raw) | Switch COM / charger BAT | Left ear pod cell + | 32 AWG silicone

1. Route. Lay the 9 wires as a flat ribbon on the back face of the top rim, 2–3 mm below the top edge (above the lens bevel), UV-resin-tack every 10–15 mm, then along each wire temple to the pods. Leave a 10 mm service loop at each hinge.
2. Continuity. Beep every conductor end-to-end and against its neighbours before you close anything.
3. Cover. Glue the tortoise rim cover strip over the ribbon and slide the painted temple sleeves over the wire runs.

## 7 Touch inlays & gestures

Three copper-tape electrodes per hinge pod, inlaid flush in a 0.1 mm recess on the outer face and painted over. The ESP32 measures each pad's capacitance with touchRead().

TapPlay / pause · answer / hang upOne pad, 40–300 ms. Ringing: answer. In a call: hang up.

Long-pressReject callOne pad held ≥ 0.8 s while ringing. Ignored otherwise.

Swipe → / ←Volume ±Media ±8 of 127; during a call HFP speaker volume ±1 of 15 (synced to the phone). Invert in the app.

1. Cut & place. Three ~11 mm pads with 1.5 mm gaps; a chevron edge lets a finger overlap two pads mid-swipe.
2. Solder the tabs on the inside of the pod wall, then seal the slot with UV resin.
3. Paint. Non-conductive finish only (mica pigments are fine; aluminium-flake metallics are not — check with a meter).
4. Tune. Firmware triggers at −15 % and releases at −10 % of a 64-sample baseline, with a 150 ms lockout. After painting, recalibrate from the app (Config bit 1).

## 8 Audio & Bluetooth stack

The original ESP32 (in the QT Py ESP32 Pico) runs classic Bluetooth (A2DP + AVRCP + HFP) and BLE on one chip. Music flows as A2DP (SBC) → 3-band EQ → I²S → 2 × MAX98357A. Each amp picks its channel from the stereo frame by its SD voltage.

- Core: Arduino-ESP32 3.3.x · board "Adafruit QT Py ESP32" · default 3 MB app partition (8 MB flash).
- Libraries: ESP32-A2DP 1.8.10+ and arduino-audio-tools. BLE on the core's Bluedroid stack — NimBLE is reported to crash alongside A2DP.
- Mode: BTDM (dual mode). No Wi-Fi, so no OTA: flash over USB.
- RAM is tight: keep one custom GATT service, watch the free heap printed on connect and on every call, switch to BluetoothA2DPSinkQueued only if you hear dropouts.

## 9 Phone calls (HFP) & the mic

### Route: plain Arduino, no ESP-IDF rebuild

I checked the prebuilt libraries that ship with Arduino-ESP32 3.3.12 (ESP-IDF 5.5.5): its sdkconfig.h for the ESP32 already sets CONFIG_BT_HFP_ENABLE, CONFIG_BT_HFP_CLIENT_ENABLE, CONFIG_BT_HFP_AUDIO_DATA_PATH_HCI, CONFIG_BT_HFP_WBS_ENABLE, CONFIG_BTDM_CTRL_BR_EDR_SCO_DATA_PATH_HCI and leaves CONFIG_BT_HFP_USE_EXTERNAL_CODEC off, so Bluedroid's own CVSD/mSBC codec is in. The pschatzmann ESP32-A2DP library only covers A2DP + AVRCP, so the sketch calls the raw esp_hf_client_* API next to it on the same Bluedroid instance. No ESP-IDF project or custom sdkconfig is needed.

- Init: after a2dp.start() → set Class of Device (Audio, hands-free, telephony) → esp_hf_client_register_callback → esp_hf_client_init → esp_hf_client_register_data_callback(in, out).
- Audio path: SCO over HCI. With the internal codec the stack hands the app 16-bit mono PCM (8 kHz CVSD or 16 kHz mSBC) in the incoming callback and pulls mic PCM through the outgoing callback after esp_hf_client_outgoing_data_ready(). These are ESP-IDF's "legacy" data callbacks (esp_hf_client_legacy_api.h): still present and linked in 5.5, but Espressif says the internal codec will be removed in a later IDF. Then switch to esp_hf_client_register_audio_data_callback + your own CVSD/mSBC codec.
- Call control: CIND call / call-setup events → state (idle, incoming, outgoing, active), notified over GATT. Tap → esp_hf_client_answer_call() or hang up (esp_hf_client_reject_call() = AT+CHUP), long-press → reject, swipe → esp_hf_client_volume_update(SPK, 0–15). Phone-side volume changes (+VGS) update the local level.
- I²S switching: music = TX only, 44.1 kHz/16-bit. When SCO comes up the firmware reopens I²S0 full duplex at 32 kHz/32-bit (the SPH0645 needs a 2.048–4.096 MHz bit clock), upsamples the far end ×2 (mSBC) or ×4 (CVSD) for the speakers and averages the mic down to 16/8 kHz. It switches back when SCO drops. The phone pauses A2DP during a call.
- Echo: open-ear speakers ~3 cm from the ear and a mic ~6 cm behind them will leak. The phone's own AEC/NR stays on (the glasses do not send AT+NREC=0); the firmware adds half-duplex ducking (mic −12 dB for 150 ms whenever the far end is louder than a threshold) and keeps the call volume moderate. No on-chip AEC: ESP-SR/AEC doesn't fit next to A2DP + BLE on this chip.
- RAM: 46.9 KB static (14 %), plus 2 × 4 KB ring buffers and a 4 KB audio task at runtime; Bluedroid HFP itself takes ~15–20 KB of heap when connected (estimate). The free heap prints on HFP connect and every SCO start: keep it above ~30 KB.

### The mic: behind the ear, for looks

Adafruit I2S MEMS Microphone Breakout, SPH0645LM4H (#3421, $6.95 (https://www.adafruit.com/product/3421)) glued to the lower-front wall of the right ear pod, its bottom port over a 1 mm hole with a short printed horn, aimed forward-down along the jaw line. Wiring (all local): BCLK → A0, LRCL → A1 (shared with the amps), DOUT → GPIO22 (SDA1 on the STEMMA QT connector, not a strapping pin), SEL → GND, 3V, GND.

Trade-off: ~9–11 cm from the mouth instead of ~3 cm on a boom means ~10 dB less voice level and more room sound. Mitigations in this build: a sensitive MEMS mic (−26 dBFS @ 94 dB SPL), 6× digital gain (MIC_GAIN), the directional horn, foam sealing so it hears outside not inside the pod, and the phone's noise reduction. If callers still say you're far away, the next step is a second mic for beamforming. That costs RAM and another wire, so it's left out of v1.

## 10 Battery & charging

Protected 120 mAh 401230 cell in the left ear pod → its + lead crosses the frame (behind the top rim) to the slide switch in the right ear pod → switch OUT → QT Py VBAT+ (diode-protected, 3–6 V) and both amps' VIN. The Micro-Lipo charger (100 mA default, right for 120 mAh) sits on the cell side of the switch and is fed from the QT Py's 5 V pad, so the one USB-C port flashes and charges.

1. Check polarity on the cell leads before soldering; insulate each joint immediately.
2. Battery sense. 100 k / 100 k divider from switched VBAT to A3 (GPIO15, ADC2, strapping pin). Firmware maps 3.3–4.2 V to % every 5 s.
3. Run time (estimates). Music ~100–130 mA → ~1 h. Calls ~110–150 mA (SCO keeps the radio busier, plus the mic and 32 kHz I²S) → ~45–60 min of talk. Connected idle ~25–40 mA → ~3–4 h of standby. 350 mAh ≈ 3×.
4. Safety. Don't charge while wearing; keep the cell from being crushed in the ear pod; never use an unprotected cell.

## 11 Firmware (Arduino)

One sketch: A2DP sink + AVRCP callbacks, HFP hands-free client with call audio and the I²S mic, touch gesture machine (tap / long-press / swipe), BLE GATT server (incl. Find chime + Call state), battery monitor and EQ presets (saved in NVS). It compiles with arduino-cli for esp32:esp32:adafruit_qtpy_esp32_pico on core 3.3.12 with ESP32-A2DP 1.8.11 + arduino-audio-tools: 1,225,668 B flash (36 % of the 3 MB app slot), 46,928 B static RAM (14 %). It has not been run on hardware.

firmware/music_glasses/music_glasses.ino⤢ Expand ⧉ Copy

/*
 * Music Glasses v1 — firmware for the Adafruit QT Py ESP32 Pico
 * ----------------------------------------------------------------------------
 * Features (Mark 1):
 *   1. Bluetooth A2DP sink, name "Muse Glasses" (stereo, one MAX98357A per side)
 *   2. Touch control: 3 copper pads per temple pod
 *        tap = play/pause, or answer / hang up during a call; long-press = reject an incoming call;
 *        swipe = volume (HFP call volume while a call is up)
 *   3. Phone calls: Bluetooth Hands-Free Profile client (HFP-HF), CVSD 8 kHz / mSBC 16 kHz over HCI,
 *        SPH0645LM4H I2S MEMS mic in the RIGHT ear pod (front edge, port aimed forward-down at the jaw line)
 *   4. BLE companion service (volume, play state, track, EQ, link, config, battery, call state, find-my-glasses chime)
 *   5. Battery monitor (A3 divider) + 3-band EQ presets
 *
 * HFP route: the Arduino-ESP32 3.3.x prebuilt ESP-IDF 5.5 libraries already ship with
 *   CONFIG_BT_HFP_ENABLE / CONFIG_BT_HFP_CLIENT_ENABLE / CONFIG_BT_HFP_AUDIO_DATA_PATH_HCI / CONFIG_BT_HFP_WBS_ENABLE = y
 *   and the internal CVSD/mSBC codec, so plain Arduino works: no ESP-IDF rebuild, no custom sdkconfig.
 *   The ESP32-A2DP library only does A2DP/AVRCP; HFP is added here with the raw esp_hf_client API
 *   (legacy PCM data callbacks: esp_hf_client_register_data_callback + esp_hf_client_outgoing_data_ready).
 *
 * Toolchain (per spec):
 *   - Arduino-ESP32 core 3.3.x, board "Adafruit QT Py ESP32" (esp32:esp32:adafruit_qtpy_esp32_pico)
 *   - Partition scheme: keep "Default (3MB APP/1.5MB SPIFFS)" (8 MB flash) — A2DP + BLE need the 3 MB app slot
 *   - Libraries: ESP32-A2DP 1.8.10+ and arduino-audio-tools (pschatzmann)
 *   - BLE: the core's Bluedroid BLE library (NOT NimBLE), controller in BTDM (dual) mode, Wi-Fi unused
 *
 * Pin map (QT Py pad -> GPIO)
 *   A0  -> GPIO26  I2S BCLK  (both amps)
 *   A1  -> GPIO25  I2S LRC   (both amps)
 *   RX  -> GPIO7   I2S DIN   (both amps)
 *   A2  -> GPIO27  T7  touch R1 (right pod, front)
 *   SDA -> GPIO4   T0  touch R2
 *   SCL -> GPIO33  T8  touch R3 (rear)
 *   TX  -> GPIO32  T9  touch L1 (left pod, front)
 *   MO  -> GPIO13  T4  touch L2
 *   SCK -> GPIO14  T6  touch L3 (rear)
 *   A3  -> GPIO15  battery sense, 100k/100k divider from switched VBAT (strapping pin, ADC2)
 *   SDA1 (STEMMA QT) -> GPIO22  I2S mic data in (SPH0645 DOUT); mic BCLK/LRCL share A0/A1, SEL -> GND (left slot)
 *   MI (GPIO12) and BOOT (GPIO0) are strapping pins: left unconnected.
 *   Amps: left SD->VIN (left channel), right 330k VIN->SD (right channel), GAIN->VIN (6 dB), VIN = switched VBAT.
 */
#include "AudioTools.h"
#include "BluetoothA2DPSink.h"
#include <BLEDevice.h>
#include <BLEServer.h>
#include <BLEUtils.h>
#include <BLE2902.h>
#include <Preferences.h>
#include "esp_gap_bt_api.h"
#include "esp_hf_client_api.h"
#include "esp_hf_client_legacy_api.h"
#include "freertos/ringbuf.h"

// ---------------------------------------------------------------- config
#define DEVICE_NAME   "Muse Glasses"
#define PIN_BCLK      26
#define PIN_LRC       25
#define PIN_DIN       7
#define PIN_VBAT      15
#define PIN_MIC       22        // SDA1 on the STEMMA QT connector — not a strapping pin
#define CALL_RATE     32000     // I2S rate during calls: SPH0645 needs BCLK >= 2.048 MHz (32 kHz x 64)
#define MIC_GAIN      6.0f      // mic sits behind the ear, ~10 cm from the mouth: extra digital gain
#define DUCK_GAIN     0.25f     // half-duplex ducking (-12 dB) while the far end is talking
#define LONG_PRESS_MS 800
static const uint8_t TOUCH_PINS[6] = {27, 4, 33, 32, 13, 14};   // R1 R2 R3 L1 L2 L3 (front -> rear)

#define TOUCH_TRIGGER   0.15f   // touched when the reading drops 15 % below baseline
#define TOUCH_RELEASE   0.10f   // released when it is back within 10 %
#define BASELINE_N      64      // baseline = running average of 64 untouched samples
#define TAP_MIN_MS      40
#define TAP_MAX_MS      300
#define SWIPE_MAX_MS    700
#define LOCKOUT_MS      150
#define VOL_STEP        8       // on the 0..127 AVRCP scale

// GATT (spec): service 9f3c0001-2b6e-4c1a-8f5d-6a7e0b1c2d3e
#define UUID_SERVICE  "9f3c0001-2b6e-4c1a-8f5d-6a7e0b1c2d3e"
#define UUID_VOLUME   "9f3c0002-2b6e-4c1a-8f5d-6a7e0b1c2d3e"  // uint8 0..127   R/W/N
#define UUID_PLAY     "9f3c0003-2b6e-4c1a-8f5d-6a7e0b1c2d3e"  // uint8 0 paused, 1 playing  R/W/N
#define UUID_TRACK    "9f3c0004-2b6e-4c1a-8f5d-6a7e0b1c2d3e"  // UTF-8 "title\x1Fartist" <=180 B  R/N
#define UUID_EQ       "9f3c0005-2b6e-4c1a-8f5d-6a7e0b1c2d3e"  // uint8 0 Flat 1 Bass+ 2 Vocal 3 Treble  R/W/N
#define UUID_LINK     "9f3c0006-2b6e-4c1a-8f5d-6a7e0b1c2d3e"  // uint8 0 disconnected 1 connected 2 streaming  R/N
#define UUID_CONFIG   "9f3c0007-2b6e-4c1a-8f5d-6a7e0b1c2d3e"  // uint8 bit0 invert swipe, bit1 recalibrate  W
#define UUID_FIND     "9f3c0008-2b6e-4c1a-8f5d-6a7e0b1c2d3e"  // uint8 seconds of chime (0 = stop), ignores volume/mute  W
#define UUID_CALL     "9f3c0009-2b6e-4c1a-8f5d-6a7e0b1c2d3e"  // uint8 0 idle 1 incoming 2 outgoing 3 active  R/N

// ---------------------------------------------------------------- audio chain: A2DP -> EQ -> I2S
I2SStream i2s;
Equalizer3Bands eq(i2s);
ConfigEqualizer3Bands eqCfg;
BluetoothA2DPSink a2dp(eq);

struct EqPreset { float lo, mid, hi; };
static const EqPreset EQ_PRESETS[4] = {
  {1.00f, 1.00f, 1.00f},   // 0 Flat
  {1.60f, 1.00f, 0.90f},   // 1 Bass+ (tiny speakers: keep it modest)
  {0.80f, 1.25f, 1.00f},   // 2 Vocal
  {0.90f, 1.00f, 1.50f},   // 3 Treble
};

// ---------------------------------------------------------------- state
volatile uint8_t gVolume = 64;
volatile uint8_t gPlaying = 0;
volatile uint8_t gLink = 0;
volatile uint8_t gEq = 0;
volatile bool gInvertSwipe = false;
volatile bool gRecalibrate = false;
volatile bool gTrackDirty = false, gPlayDirty = false, gVolDirty = false, gLinkDirty = false;
char gTitle[128] = "", gArtist[96] = "";
portMUX_TYPE gMux = portMUX_INITIALIZER_UNLOCKED;

Preferences prefs;
BLECharacteristic *chVol, *chPlay, *chTrack, *chEq, *chLink, *chCfg, *chBatt, *chFind, *chCall;

// ---------------------------------------------------------------- call + chime state
enum CallState : uint8_t { CALL_IDLE = 0, CALL_INCOMING = 1, CALL_OUTGOING = 2, CALL_ACTIVE = 3 };
volatile uint8_t gCall = CALL_IDLE, gCallVol = 10;          // HFP speaker volume 0..15
volatile bool gScoUp = false, gScoWide = false, gScoChanged = false, gCallDirty = false;
volatile uint32_t gChimeUntil = 0;
bool gAudioCallMode = false;                                // I2S currently in 32 kHz full-duplex call mode
RingbufHandle_t rxRing = nullptr, txRing = nullptr;         // phone -> speakers, mic -> phone (16-bit mono PCM)
bool bleClient = false;

// ---------------------------------------------------------------- helpers
void applyEq(uint8_t p) {
  if (p > 3) p = 0;
  gEq = p;
  eqCfg.gain_low = EQ_PRESETS[p].lo;
  eqCfg.gain_medium = EQ_PRESETS[p].mid;
  eqCfg.gain_high = EQ_PRESETS[p].hi;
  eq.begin(eqCfg);                         // re-computes the filter gains
  prefs.putUChar("eq", p);                 // persist (NVS)
}

void setVolume(int v, bool fromPhone = false) {
  v = constrain(v, 0, 127);
  gVolume = (uint8_t)v;
  if (!fromPhone) a2dp.set_volume(gVolume); // also sent to the phone over AVRCP (absolute volume)
  gVolDirty = true;
}

void notifyU8(BLECharacteristic *c, uint8_t v) {
  c->setValue(&v, 1);
  if (bleClient) c->notify();
}

// ---------------------------------------------------------------- A2DP callbacks
void onConnState(esp_a2d_connection_state_t s, void *) {
  if (s == ESP_A2D_CONNECTION_STATE_CONNECTED) Serial.printf("A2DP connected, free heap %u\n", ESP.getFreeHeap());
  gLink = (s == ESP_A2D_CONNECTION_STATE_CONNECTED) ? 1 : 0;
  gLinkDirty = true;
}
void onAudioState(esp_a2d_audio_state_t s, void *) {
  if (gLink) { gLink = (s == ESP_A2D_AUDIO_STATE_STARTED) ? 2 : 1; gLinkDirty = true; }
}
void onPlayStatus(esp_avrc_playback_stat_t st) {
  gPlaying = (st == ESP_AVRC_PLAYBACK_PLAYING) ? 1 : 0;
  gPlayDirty = true;
}
void onRemoteVolume(int v) { gVolume = (uint8_t)constrain(v, 0, 127); gVolDirty = true; }
void onMetadata(uint8_t id, const uint8_t *text) {
  portENTER_CRITICAL(&gMux);
  if (id == ESP_AVRC_MD_ATTR_TITLE)  { strncpy(gTitle, (const char *)text, sizeof(gTitle) - 1); gTitle[sizeof(gTitle) - 1] = 0; }
  if (id == ESP_AVRC_MD_ATTR_ARTIST) { strncpy(gArtist, (const char *)text, sizeof(gArtist) - 1); gArtist[sizeof(gArtist) - 1] = 0; }
  portEXIT_CRITICAL(&gMux);
  gTrackDirty = true;
}

// ---------------------------------------------------------------- BLE
class ServerCB : public BLEServerCallbacks {
  void onConnect(BLEServer *) override { bleClient = true; }
  void onDisconnect(BLEServer *s) override { bleClient = false; s->getAdvertising()->start(); }
};
class WriteCB : public BLECharacteristicCallbacks {
  void onWrite(BLECharacteristic *c) override {
    String v = c->getValue();
    if (v.length() < 1) return;
    uint8_t b = (uint8_t)v[0];
    if (c == chVol) setVolume(b);
    else if (c == chPlay) { if (b) a2dp.play(); else a2dp.pause(); }
    else if (c == chEq) { applyEq(b); notifyU8(chEq, gEq); }
    else if (c == chFind) { gChimeUntil = b ? millis() + 1000UL * b : 0; }
    else if (c == chCfg) { gInvertSwipe = b & 0x01; prefs.putBool("inv", gInvertSwipe); if (b & 0x02) gRecalibrate = true; }
  }
};

BLECharacteristic *mkChar(BLEService *s, const char *uuid, uint32_t props) {
  BLECharacteristic *c = s->createCharacteristic(uuid, props);
  if (props & BLECharacteristic::PROPERTY_NOTIFY) c->addDescriptor(new BLE2902());
  if (props & BLECharacteristic::PROPERTY_WRITE) c->setCallbacks(new WriteCB());
  return c;
}

void bleBegin() {
  BLEDevice::init(DEVICE_NAME);
  BLEDevice::setMTU(185);                                   // the app requests 185 too
  BLEServer *srv = BLEDevice::createServer();
  srv->setCallbacks(new ServerCB());
  BLEService *svc = srv->createService(BLEUUID(UUID_SERVICE), 24);
  const uint32_t R = BLECharacteristic::PROPERTY_READ, W = BLECharacteristic::PROPERTY_WRITE, N = BLECharacteristic::PROPERTY_NOTIFY;
  chVol   = mkChar(svc, UUID_VOLUME, R | W | N);
  chPlay  = mkChar(svc, UUID_PLAY,   R | W | N);
  chTrack = mkChar(svc, UUID_TRACK,  R | N);
  chEq    = mkChar(svc, UUID_EQ,     R | W | N);
  chLink  = mkChar(svc, UUID_LINK,   R | N);
  chCfg   = mkChar(svc, UUID_CONFIG, W);
  chFind  = mkChar(svc, UUID_FIND,   W);
  chCall  = mkChar(svc, UUID_CALL,   R | N);
  uint8_t z = 0; chVol->setValue((uint8_t *)&gVolume, 1); chPlay->setValue(&z, 1); chEq->setValue(&z, 1); chLink->setValue(&z, 1); chCall->setValue(&z, 1); chTrack->setValue("");
  svc->start();
  BLEService *bas = srv->createService(BLEUUID((uint16_t)0x180F));   // standard Battery Service
  chBatt = bas->createCharacteristic(BLEUUID((uint16_t)0x2A19), R | N);
  chBatt->addDescriptor(new BLE2902());
  bas->start();
  BLEAdvertising *adv = BLEDevice::getAdvertising();
  adv->addServiceUUID(UUID_SERVICE);
  adv->setScanResponse(true);
  BLEDevice::startAdvertising();
}

// ---------------------------------------------------------------- touch
struct Pad { float base; bool down; uint32_t t0; };
Pad pads[6];

void calibrate() {
  for (int i = 0; i < 6; i++) {
    uint32_t sum = 0;
    for (int k = 0; k < BASELINE_N; k++) { sum += touchRead(TOUCH_PINS[i]); delay(2); }
    pads[i] = { sum / (float)BASELINE_N, false, 0 };
  }
}

struct Pod {            // gesture tracker per hinge pod
  int first = -1, last = -1; uint32_t tStart = 0, lockUntil = 0; bool active = false;
};
Pod pod[2];             // 0 = right, 1 = left

void onTap(int side) {                   // either pod
  if (gCall == CALL_INCOMING) { esp_hf_client_answer_call(); return; }
  if (gCall == CALL_ACTIVE || gCall == CALL_OUTGOING) { esp_hf_client_reject_call(); return; }   // AT+CHUP = hang up
  if (gPlaying) a2dp.pause(); else a2dp.play();                                                  // music: play / pause
}
void onLongPress(int side) {             // only meaningful while ringing
  if (gCall == CALL_INCOMING) esp_hf_client_reject_call();
}
void onSwipe(int side, int dir) {        // dir +1 = rear -> front (toward the lens)
  if (gInvertSwipe) dir = -dir;
  if (gCall != CALL_IDLE) {               // call volume, synced to the phone over HFP (+VGS)
    gCallVol = constrain((int)gCallVol + dir, 0, 15);
    esp_hf_client_volume_update(ESP_HF_VOLUME_CONTROL_TARGET_SPK, gCallVol);
    return;
  }
  setVolume(gVolume + dir * VOL_STEP);
}

void pollTouch() {
  const uint32_t now = millis();
  for (int s = 0; s < 2; s++) {
    Pod &p = pod[s];
    int touched = -1;
    for (int k = 0; k < 3; k++) {
      Pad &d = pads[s * 3 + k];
      float v = touchRead(TOUCH_PINS[s * 3 + k]);
      if (!d.down && v < d.base * (1.0f - TOUCH_TRIGGER)) { d.down = true; d.t0 = now; }
      else if (d.down && v > d.base * (1.0f - TOUCH_RELEASE)) d.down = false;
      if (!d.down) d.base += (v - d.base) / BASELINE_N;          // track drift only while untouched
      if (d.down && touched < 0) touched = k;
    }
    if (now < p.lockUntil) continue;
    if (touched >= 0) {
      if (!p.active) { p.active = true; p.first = p.last = touched; p.tStart = now; }
      else p.last = touched;
    } else if (p.active) {                                       // finger lifted: classify
      p.active = false;
      uint32_t dur = now - p.tStart;
      if (p.first != p.last && dur <= SWIPE_MAX_MS) { onSwipe(s, p.first > p.last ? +1 : -1); p.lockUntil = now + LOCKOUT_MS; }
      else if (dur >= TAP_MIN_MS && dur <= TAP_MAX_MS) { onTap(s); p.lockUntil = now + LOCKOUT_MS; }
      else if (p.first == p.last && dur >= LONG_PRESS_MS) { onLongPress(s); p.lockUntil = now + LOCKOUT_MS; }
    }
  }
}

// ---------------------------------------------------------------- HFP hands-free client (calls)
void onHfp(esp_hf_client_cb_event_t ev, esp_hf_client_cb_param_t *p) {
  switch (ev) {
    case ESP_HF_CLIENT_AUDIO_STATE_EVT:
      gScoUp = p->audio_stat.state == ESP_HF_CLIENT_AUDIO_STATE_CONNECTED || p->audio_stat.state == ESP_HF_CLIENT_AUDIO_STATE_CONNECTED_MSBC;
      gScoWide = p->audio_stat.state == ESP_HF_CLIENT_AUDIO_STATE_CONNECTED_MSBC;   // mSBC = 16 kHz, CVSD = 8 kHz
      gScoChanged = true;
      break;
    case ESP_HF_CLIENT_CIND_CALL_SETUP_EVT:
      if (p->call_setup.status == ESP_HF_CALL_SETUP_STATUS_INCOMING) gCall = CALL_INCOMING;
      else if (p->call_setup.status != ESP_HF_CALL_SETUP_STATUS_IDLE) gCall = CALL_OUTGOING;
      else if (gCall != CALL_ACTIVE) gCall = CALL_IDLE;
      gCallDirty = true; break;
    case ESP_HF_CLIENT_CIND_CALL_EVT:
      gCall = p->call.status == ESP_HF_CALL_STATUS_CALL_IN_PROGRESS ? CALL_ACTIVE : CALL_IDLE;
      gCallDirty = true; break;
    case ESP_HF_CLIENT_VOLUME_CONTROL_EVT:
      if (p->volume_control.type == ESP_HF_VOLUME_CONTROL_TARGET_SPK) gCallVol = p->volume_control.volume;
      break;
    case ESP_HF_CLIENT_CONNECTION_STATE_EVT:
      Serial.printf("HFP state %d, free heap %u\n", p->conn_stat.state, ESP.getFreeHeap());
      break;
    default: break;
  }
}
// Bluedroid's internal CVSD/mSBC codec hands us 16-bit mono PCM (8 or 16 kHz)
void hfpIncoming(const uint8_t *buf, uint32_t len) { if (rxRing) xRingbufferSend(rxRing, buf, len, 0); }
uint32_t hfpOutgoing(uint8_t *buf, uint32_t len) {
  if (!txRing) return 0;
  size_t got = 0; uint8_t *d = (uint8_t *)xRingbufferReceiveUpTo(txRing, &got, 0, len);
  if (!d) return 0;
  memcpy(buf, d, got); vRingbufferReturnItem(txRing, d);
  return got;
}
void hfpBegin() {
  esp_bt_cod_t cod = {};                                   // advertise as an audio hands-free device
  cod.major = ESP_BT_COD_MAJOR_DEV_AV; cod.minor = 0x02;
  cod.service = ESP_BT_COD_SRVC_AUDIO | ESP_BT_COD_SRVC_RENDERING | ESP_BT_COD_SRVC_TELEPHONY;
  esp_bt_gap_set_cod(cod, ESP_BT_INIT_COD);
  rxRing = xRingbufferCreate(4096, RINGBUF_TYPE_BYTEBUF);
  txRing = xRingbufferCreate(4096, RINGBUF_TYPE_BYTEBUF);
  esp_hf_client_register_callback(onHfp);
  esp_hf_client_init();
  esp_hf_client_register_data_callback(hfpIncoming, hfpOutgoing);
}

// I2S mode switch: music = TX 44.1 kHz 16-bit (A2DP -> EQ); call = full duplex 32 kHz 32-bit (mic needs 64 BCLK/frame)
void i2sMusicMode() {
  i2s.end();
  auto c = i2s.defaultConfig(TX_MODE);
  c.pin_bck = PIN_BCLK; c.pin_ws = PIN_LRC; c.pin_data = PIN_DIN;
  c.sample_rate = 44100; c.channels = 2; c.bits_per_sample = 16;
  i2s.begin(c); gAudioCallMode = false;
}
void i2sCallMode() {
  i2s.end();
  auto c = i2s.defaultConfig(RXTX_MODE);
  c.pin_bck = PIN_BCLK; c.pin_ws = PIN_LRC; c.pin_data = PIN_DIN; c.pin_data_rx = PIN_MIC;
  c.sample_rate = CALL_RATE; c.channels = 2; c.bits_per_sample = 32;
  i2s.begin(c); gAudioCallMode = true;
}

// call audio task: speakers <- rxRing (upsampled x2/x4), mic -> txRing (decimated /2 or /4), half-duplex ducking
void callAudioTask(void *) {
  static int32_t frame[2 * 64];             // 64 stereo 32-bit frames = 2 ms @ 32 kHz
  float duckHold = 0;
  for (;;) {
    if (!gAudioCallMode) { vTaskDelay(pdMS_TO_TICKS(10)); continue; }
    const int up = gScoWide ? 2 : 4;        // 16k -> 32k, 8k -> 32k
    const int nIn = 64 / up;
    // speakers
    int16_t v[32] = {0}; size_t got = 0;
    uint8_t *d = (uint8_t *)xRingbufferReceiveUpTo(rxRing, &got, 0, nIn * 2);
    if (d) { memcpy(v, d, got); vRingbufferReturnItem(rxRing, d); }
    float energy = 0; const float g = (gCallVol + 1) / 16.0f;
    for (int i = 0; i < nIn; i++) {
      energy += fabsf(v[i]);
      int16_t a = v[i], b = (i + 1 < nIn) ? v[i + 1] : v[i];
      for (int k = 0; k < up; k++) { int32_t s = (int32_t)((a + (b - a) * k / up) * g) << 16; frame[2 * (i * up + k)] = s; frame[2 * (i * up + k) + 1] = s; }
    }
    i2s.write((uint8_t *)frame, sizeof(frame));
    if (energy / nIn > 600) duckHold = 0.15f; else duckHold = fmaxf(0, duckHold - 0.002f);
    // mic (left slot, SPH0645: 18-bit data MSB-aligned in 32 bits)
    size_t n = i2s.readBytes((uint8_t *)frame, sizeof(frame));
    int16_t out[32]; const int frames = n / 8, dn = up; int m = 0;
    const float mg = MIC_GAIN * (duckHold > 0 ? DUCK_GAIN : 1.0f);
    for (int i = 0; i + dn <= frames && m < 32; i += dn) {
      int32_t acc = 0; for (int k = 0; k < dn; k++) acc += frame[2 * (i + k)] >> 14;
      out[m++] = (int16_t)constrain((int32_t)(acc / dn * mg), -32768, 32767);
    }
    if (m) { xRingbufferSend(txRing, out, m * 2, 0); esp_hf_client_outgoing_data_ready(); }
  }
}

// find-my-glasses chime: fixed level, ignores media volume and mute; only outside calls
void playChimeBurst() {
  static int16_t buf[2 * 441];               // 10 ms @ 44.1 kHz stereo
  static uint32_t ph = 0;
  const uint32_t t = millis() % 1000;
  const float f = t < 150 ? 1568.0f : (t < 300 ? 2093.0f : 0);   // G6 - C7 blip, then silence
  for (int i = 0; i < 441; i++) { int16_t s = f ? (int16_t)(12000 * sinf(2 * PI * f * (ph++) / 44100.0f)) : 0; buf[2 * i] = buf[2 * i + 1] = s; }
  i2s.write((uint8_t *)buf, sizeof(buf));
}

// ---------------------------------------------------------------- battery
uint8_t batteryPercent() {
  // GPIO15 is ADC2. ADC2 conflicts with Wi-Fi (unused here); retry a few times anyway.
  uint32_t mv = 0; int ok = 0;
  for (int i = 0; i < 8; i++) { int r = analogReadMilliVolts(PIN_VBAT); if (r > 0) { mv += r; ok++; } }
  if (!ok) return 0;
  float v = 2.0f * mv / ok / 1000.0f;                 // 100k/100k divider
  static const float V[] = {3.30f, 3.60f, 3.70f, 3.75f, 3.80f, 3.90f, 4.00f, 4.10f, 4.20f};
  static const uint8_t P[] = {0, 10, 25, 40, 50, 65, 80, 92, 100};
  if (v <= V[0]) return 0;
  for (int i = 1; i < 9; i++) if (v < V[i]) return P[i - 1] + (uint8_t)((v - V[i - 1]) / (V[i] - V[i - 1]) * (P[i] - P[i - 1]));
  return 100;
}

// ---------------------------------------------------------------- setup / loop
void setup() {
  Serial.begin(115200);
  analogSetPinAttenuation(PIN_VBAT, ADC_11db);

  auto cfg = i2s.defaultConfig(TX_MODE);
  cfg.pin_bck = PIN_BCLK; cfg.pin_ws = PIN_LRC; cfg.pin_data = PIN_DIN;
  cfg.sample_rate = 44100; cfg.channels = 2; cfg.bits_per_sample = 16;
  i2s.begin(cfg);

  eqCfg = eq.defaultConfig();
  eqCfg.channels = 2; eqCfg.bits_per_sample = 16; eqCfg.sample_rate = 44100;
  eqCfg.freq_low = 250; eqCfg.freq_high = 4000;
  prefs.begin("muse", false);
  gInvertSwipe = prefs.getBool("inv", false);
  applyEq(prefs.getUChar("eq", 0));

  a2dp.set_default_bt_mode(ESP_BT_MODE_BTDM);         // classic (A2DP) + BLE at the same time
  a2dp.set_on_connection_state_changed(onConnState);
  a2dp.set_on_audio_state_changed(onAudioState);
  a2dp.set_avrc_rn_playstatus_callback(onPlayStatus);
  a2dp.set_avrc_rn_volumechange(onRemoteVolume);
  a2dp.set_avrc_metadata_attribute_mask(ESP_AVRC_MD_ATTR_TITLE | ESP_AVRC_MD_ATTR_ARTIST);
  a2dp.set_avrc_metadata_callback(onMetadata);
  a2dp.set_volume(gVolume);
  a2dp.start(DEVICE_NAME, true);                      // auto-reconnect to the last phone

  hfpBegin();                                         // HFP client on the same Bluedroid instance as A2DP
  bleBegin();
  calibrate();
  xTaskCreatePinnedToCore(callAudioTask, "callAudio", 4096, nullptr, 10, nullptr, 1);
  uint8_t e = gEq; chEq->setValue(&e, 1);
  Serial.printf("Muse Glasses ready, free heap %u\n", ESP.getFreeHeap());
}

void loop() {
  pollTouch();

  if (gRecalibrate) { gRecalibrate = false; calibrate(); }
  if (gScoChanged) {                                  // SCO up/down: switch the I2S bus (phone suspends A2DP during calls)
    gScoChanged = false;
    if (gScoUp && !gAudioCallMode) { i2sCallMode(); Serial.printf("SCO %s, free heap %u\n", gScoWide ? "mSBC 16k" : "CVSD 8k", ESP.getFreeHeap()); }
    else if (!gScoUp && gAudioCallMode) { i2sMusicMode(); applyEq(gEq); }
  }
  if (gCallDirty) { gCallDirty = false; notifyU8(chCall, gCall); }
  if (gChimeUntil && !gAudioCallMode) {
    static bool paused = false;
    if (millis() < gChimeUntil) { if (gPlaying && !paused) { a2dp.pause(); paused = true; } playChimeBurst(); return; }
    gChimeUntil = 0; paused = false;
  }
  if (gVolDirty)  { gVolDirty = false;  notifyU8(chVol, gVolume); }
  if (gPlayDirty) { gPlayDirty = false; notifyU8(chPlay, gPlaying); }
  if (gLinkDirty) { gLinkDirty = false; notifyU8(chLink, gLink); }
  if (gTrackDirty) {
    gTrackDirty = false;
    char buf[181];
    portENTER_CRITICAL(&gMux);
    snprintf(buf, sizeof(buf), "%s\x1F%s", gTitle, gArtist);   // U+241F-style unit separator between title and artist
    portEXIT_CRITICAL(&gMux);
    chTrack->setValue((uint8_t *)buf, strlen(buf));
    if (bleClient) chTrack->notify();
  }

  static uint32_t tBatt = 0;
  if (millis() - tBatt > 5000 || tBatt == 0) {      // every 5 s
    tBatt = millis() | 1;
    uint8_t pct = batteryPercent();
    chBatt->setValue(&pct, 1);
    if (bleClient) chBatt->notify();
  }
  delay(10);
}

## 12 Companion app (Flutter)

Flutter + flutter_blue_plus: scan for the service UUID, connect, request MTU 185, subscribe to every notify characteristic. Audio itself is paired in the phone's Bluetooth settings. flutter_blue_plus is free for personal use; check its licence on pub.dev before selling anything. Run flutter create . inside app/ to generate the platform folders, then add the Bluetooth + location permissions listed in app/README.md.

app/pubspec.yaml⧉ Copy

name: muse_glasses
description: Companion app for Music Glasses Mark 1 (BLE control, call state, find my glasses).
publish_to: "none"
version: 0.1.0+1

environment:
  sdk: ">=3.3.0 <4.0.0"

dependencies:
  flutter:
    sdk: flutter
  flutter_blue_plus: ^1.35.0   # check the licence terms on pub.dev before shipping (see Docs → Companion app)
  provider: ^6.1.2
  geolocator: ^13.0.1          # phone location at the last disconnect (stored on the phone only)
  shared_preferences: ^2.3.2   # persists "last seen"

dev_dependencies:
  flutter_test:
    sdk: flutter
  flutter_lints: ^4.0.0

flutter:
  uses-material-design: true

app/lib/ble/glasses_client.dart⤢ Expand ⧉ Copy

// BLE client for the Music Glasses GATT service (Bluedroid server on the QT Py ESP32 Pico).
// Audio itself goes over classic Bluetooth A2DP (pair "Muse Glasses" in the phone's BT settings);
// this link only carries control + status.
import 'dart:async';
import 'dart:convert';

import 'package:flutter_blue_plus/flutter_blue_plus.dart';

class GattIds {
  static final service = Guid('9f3c0001-2b6e-4c1a-8f5d-6a7e0b1c2d3e');
  static final volume = Guid('9f3c0002-2b6e-4c1a-8f5d-6a7e0b1c2d3e'); // uint8 0..127   R/W/N
  static final play = Guid('9f3c0003-2b6e-4c1a-8f5d-6a7e0b1c2d3e'); //   uint8 0/1      R/W/N
  static final track = Guid('9f3c0004-2b6e-4c1a-8f5d-6a7e0b1c2d3e'); //  "title\u001Fartist" R/N
  static final eq = Guid('9f3c0005-2b6e-4c1a-8f5d-6a7e0b1c2d3e'); //     uint8 0..3     R/W/N
  static final link = Guid('9f3c0006-2b6e-4c1a-8f5d-6a7e0b1c2d3e'); //   uint8 0/1/2    R/N
  static final config = Guid('9f3c0007-2b6e-4c1a-8f5d-6a7e0b1c2d3e'); // uint8 bits     W
  static final findChime = Guid('9f3c0008-2b6e-4c1a-8f5d-6a7e0b1c2d3e'); // uint8 seconds (0 = stop)  W
  static final callState = Guid('9f3c0009-2b6e-4c1a-8f5d-6a7e0b1c2d3e'); // uint8 0 idle 1 in 2 out 3 active  R/N
  static final batteryService = Guid('180f');
  static final batteryLevel = Guid('2a19');
}

class GlassesClient {
  static const deviceName = 'Muse Glasses';
  BluetoothDevice? _dev;
  final Map<Guid, BluetoothCharacteristic> _ch = {};
  final _subs = <StreamSubscription>[];

  final volume = StreamController<int>.broadcast();
  final playing = StreamController<bool>.broadcast();
  final track = StreamController<(String, String)>.broadcast();
  final eq = StreamController<int>.broadcast();
  final link = StreamController<int>.broadcast();
  final battery = StreamController<int>.broadcast();
  final connection = StreamController<bool>.broadcast();
  final call = StreamController<int>.broadcast();
  final rssi = StreamController<int>.broadcast();       // dBm, from readRssi() or advertising
  Timer? _rssiTimer;

  Stream<List<ScanResult>> scan({Duration timeout = const Duration(seconds: 8)}) {
    FlutterBluePlus.startScan(withServices: [GattIds.service], timeout: timeout);
    return FlutterBluePlus.scanResults;
  }

  Future<void> connect(BluetoothDevice d) async {
    await FlutterBluePlus.stopScan();
    _dev = d;
    await d.connect(autoConnect: false);
    _subs.add(d.connectionState.listen((s) => connection.add(s == BluetoothConnectionState.connected)));
    _rssiTimer?.cancel();
    _rssiTimer = Timer.periodic(const Duration(milliseconds: 500), (_) async {
      try { rssi.add(await d.readRssi()); } catch (_) {}
    });
    try {
      await d.requestMtu(185); // Android only; iOS negotiates on its own
    } catch (_) {}
    for (final svc in await d.discoverServices()) {
      for (final c in svc.characteristics) {
        _ch[c.uuid] = c;
      }
    }
    await _listenU8(GattIds.volume, volume);
    await _listenU8(GattIds.eq, eq);
    await _listenU8(GattIds.link, link);
    await _listenU8(GattIds.batteryLevel, battery);
    await _listenU8(GattIds.callState, call);
    await _listen(GattIds.play, (v) => playing.add(v.isNotEmpty && v[0] == 1));
    await _listen(GattIds.track, (v) {
      final parts = utf8.decode(v, allowMalformed: true).split('\u001F');
      track.add((parts.first, parts.length > 1 ? parts[1] : ''));
    });
  }

  Future<void> _listenU8(Guid id, StreamController<int> out) =>
      _listen(id, (v) { if (v.isNotEmpty) out.add(v[0]); });

  Future<void> _listen(Guid id, void Function(List<int>) onValue) async {
    final c = _ch[id];
    if (c == null) return;
    _subs.add(c.onValueReceived.listen(onValue));
    if (c.properties.notify) await c.setNotifyValue(true);
    if (c.properties.read) onValue(await c.read());
  }

  Future<void> _write(Guid id, int v) async => _ch[id]?.write([v & 0xFF], withoutResponse: false);

  Future<void> setVolume(int v) => _write(GattIds.volume, v.clamp(0, 127));
  Future<void> setPlaying(bool p) => _write(GattIds.play, p ? 1 : 0);
  Future<void> setEq(int preset) => _write(GattIds.eq, preset.clamp(0, 3));
  /// Find my glasses: chime for [seconds] at a fixed level, even if the media volume is 0. 0 stops it.
  Future<void> playFindSound([int seconds = 10]) => _write(GattIds.findChime, seconds.clamp(0, 60));

  /// While NOT connected: scan for the service and report the advertising RSSI ("hotter / colder").
  StreamSubscription<List<ScanResult>> watchAdvertisedRssi() {
    FlutterBluePlus.startScan(withServices: [GattIds.service], continuousUpdates: true, removeIfGone: const Duration(seconds: 6));
    return FlutterBluePlus.scanResults.listen((rs) {
      for (final r in rs) {
        rssi.add(r.rssi);
      }
    });
  }

  Future<void> setConfig({bool invertSwipe = false, bool recalibrate = false}) =>
      _write(GattIds.config, (invertSwipe ? 1 : 0) | (recalibrate ? 2 : 0));

  Future<void> disconnect() async {
    _rssiTimer?.cancel();
    for (final s in _subs) {
      await s.cancel();
    }
    _subs.clear();
    _ch.clear();
    await _dev?.disconnect();
  }
}

app/lib/state/glasses_state.dart⤢ Expand ⧉ Copy

import 'dart:async';
import 'dart:math' as math;

import 'package:flutter/foundation.dart';
import 'package:flutter_blue_plus/flutter_blue_plus.dart';
import 'package:geolocator/geolocator.dart';
import 'package:shared_preferences/shared_preferences.dart';

import '../ble/glasses_client.dart';

const eqNames = ['Flat', 'Bass+', 'Vocal', 'Treble'];
const linkNames = ['Not connected', 'Connected', 'Streaming'];
const callNames = ['No call', 'Incoming call: tap to answer, hold to reject', 'Calling…', 'In a call: tap to hang up'];

class LastSeen {
  LastSeen(this.when, this.lat, this.lon);
  final DateTime when;
  final double? lat, lon;
}

class GlassesState extends ChangeNotifier {
  GlassesState(this.client) {
    _subs.addAll([
      client.connection.stream.listen((c) {
        if (connected && !c) _rememberDisconnect(); // link just dropped: save time + phone location
        connected = c;
        if (c) lastRssiAt = DateTime.now();
        notifyListeners();
      }),
      client.call.stream.listen((v) { callState = v; notifyListeners(); }),
      client.rssi.stream.listen((r) {
        rssi = rssi == null ? r.toDouble() : rssi! * 0.7 + r * 0.3; // smooth the ±5–10 dB jitter
        lastRssiAt = DateTime.now();
        notifyListeners();
      }),
      client.volume.stream.listen((v) { volume = v; notifyListeners(); }),
      client.playing.stream.listen((p) { playing = p; notifyListeners(); }),
      client.track.stream.listen((t) { title = t.$1; artist = t.$2; notifyListeners(); }),
      client.eq.stream.listen((e) { eq = e; notifyListeners(); }),
      client.link.stream.listen((l) { audioLink = l; notifyListeners(); }),
      client.battery.stream.listen((b) { battery = b; notifyListeners(); }),
    ]);
    _loadLastSeen();
  }

  final GlassesClient client;
  final _subs = <StreamSubscription>[];

  bool connected = false;
  int volume = 64, eq = 0, audioLink = 0, battery = 0;
  bool playing = false, invertSwipe = false;
  String title = '', artist = '';
  int callState = 0;
  double? rssi;          // smoothed dBm
  DateTime? lastRssiAt;  // last time we heard the glasses at all
  LastSeen? lastSeen;    // phone location at the last disconnect

  bool get inRange => lastRssiAt != null && DateTime.now().difference(lastRssiAt!) < const Duration(seconds: 8);

  /// 0 = cold … 1 = hot. −95 dBm ≈ edge of range, −45 dBm ≈ right next to the phone.
  double get warmth => rssi == null ? 0 : ((rssi! + 95) / 50).clamp(0.0, 1.0);

  /// Very rough distance from a log-distance model (txPower −59 dBm @ 1 m, n = 2.5). Indoors it is only a hint.
  String get distanceHint {
    if (rssi == null || !inRange) return 'out of range';
    final d = math.pow(10, (-59 - rssi!) / 25).toDouble();
    if (d < 1) return 'within ~1 m';
    if (d < 3) return '≈ 1–3 m';
    if (d < 8) return '≈ 3–8 m';
    return '> 8 m';
  }

  Future<void> playFindSound() => client.playFindSound(10);
  Future<void> stopFindSound() => client.playFindSound(0);
  StreamSubscription<List<ScanResult>> watchWhileDisconnected() => client.watchAdvertisedRssi();

  Future<void> _rememberDisconnect() async {
    double? lat, lon;
    try {
      var perm = await Geolocator.checkPermission();
      if (perm == LocationPermission.denied) perm = await Geolocator.requestPermission();
      if (perm == LocationPermission.whileInUse || perm == LocationPermission.always) {
        final p = await Geolocator.getCurrentPosition(locationSettings: const LocationSettings(accuracy: LocationAccuracy.high, timeLimit: Duration(seconds: 10)));
        lat = p.latitude; lon = p.longitude;
      }
    } catch (_) {/* no fix: keep the time only */}
    lastSeen = LastSeen(DateTime.now(), lat, lon);
    final sp = await SharedPreferences.getInstance(); // stored on this phone only
    await sp.setString('lastSeen.when', lastSeen!.when.toIso8601String());
    if (lat != null && lon != null) { await sp.setDouble('lastSeen.lat', lat); await sp.setDouble('lastSeen.lon', lon); }
    else { await sp.remove('lastSeen.lat'); await sp.remove('lastSeen.lon'); }
    notifyListeners();
  }

  Future<void> _loadLastSeen() async {
    final sp = await SharedPreferences.getInstance();
    final w = sp.getString('lastSeen.when');
    if (w != null) { lastSeen = LastSeen(DateTime.parse(w), sp.getDouble('lastSeen.lat'), sp.getDouble('lastSeen.lon')); notifyListeners(); }
  }

  Stream<List<ScanResult>> scan() => client.scan();
  Future<void> connect(BluetoothDevice d) => client.connect(d);
  Future<void> disconnect() => client.disconnect();

  Future<void> setVolume(int v) { volume = v; notifyListeners(); return client.setVolume(v); }
  Future<void> togglePlay() => client.setPlaying(!playing);
  Future<void> setEq(int e) { eq = e; notifyListeners(); return client.setEq(e); }
  Future<void> setInvertSwipe(bool v) { invertSwipe = v; notifyListeners(); return client.setConfig(invertSwipe: v); }
  Future<void> recalibrate() => client.setConfig(invertSwipe: invertSwipe, recalibrate: true);

  @override
  void dispose() {
    for (final s in _subs) {
      s.cancel();
    }
    super.dispose();
  }
}

app/lib/screens/control_screen.dart⤢ Expand ⧉ Copy

import 'package:flutter/material.dart';
import 'package:provider/provider.dart';

import '../state/glasses_state.dart';
import 'find_screen.dart';

class ControlScreen extends StatelessWidget {
  const ControlScreen({super.key});

  @override
  Widget build(BuildContext context) {
    final s = context.watch<GlassesState>();
    return Scaffold(
      appBar: AppBar(
        title: const Text('Muse Glasses'),
        actions: [
          Padding(padding: const EdgeInsets.only(right: 12), child: Center(child: Text('🔋 ${s.battery}%'))),
          IconButton(icon: const Icon(Icons.travel_explore), tooltip: 'Find my glasses',
              onPressed: () => Navigator.push(context, MaterialPageRoute(builder: (_) => const FindScreen()))),
          IconButton(icon: const Icon(Icons.link_off), onPressed: s.disconnect),
        ],
      ),
      body: ListView(padding: const EdgeInsets.all(16), children: [
        Text(linkNames[s.audioLink.clamp(0, 2)], style: Theme.of(context).textTheme.labelLarge),
        if (s.callState != 0)
          Card(
            color: Theme.of(context).colorScheme.primaryContainer,
            child: ListTile(leading: const Icon(Icons.call), title: Text(callNames[s.callState.clamp(0, 3)])),
          ),
        const SizedBox(height: 12),
        Text(s.title.isEmpty ? '—' : s.title, style: Theme.of(context).textTheme.headlineSmall),
        Text(s.artist),
        const SizedBox(height: 8),
        Center(
          child: IconButton.filled(
            iconSize: 48,
            icon: Icon(s.playing ? Icons.pause : Icons.play_arrow),
            onPressed: s.togglePlay,
          ),
        ),
        const SizedBox(height: 16),
        Text('Volume ${s.volume}/127'),
        Slider(value: s.volume.toDouble(), max: 127, divisions: 127, onChanged: (v) => s.setVolume(v.round())),
        const SizedBox(height: 8),
        const Text('EQ'),
        Wrap(spacing: 8, children: [
          for (var i = 0; i < eqNames.length; i++)
            ChoiceChip(label: Text(eqNames[i]), selected: s.eq == i, onSelected: (_) => s.setEq(i)),
        ]),
        const Divider(height: 32),
        SwitchListTile(title: const Text('Invert swipe direction'), value: s.invertSwipe, onChanged: s.setInvertSwipe),
        ListTile(
          title: const Text('Recalibrate touch pads'),
          subtitle: const Text('Take the glasses off, keep fingers away, then tap'),
          trailing: const Icon(Icons.touch_app),
          onTap: s.recalibrate,
        ),
      ]),
    );
  }
}

app/lib/screens/find_screen.dart⤢ Expand ⧉ Copy

import 'dart:async';

import 'package:flutter/material.dart';
import 'package:flutter_blue_plus/flutter_blue_plus.dart';
import 'package:provider/provider.dart';

import '../state/glasses_state.dart';

/// Find my glasses: hotter/colder RSSI meter, "last seen" (phone location at the last disconnect) and Play sound.
class FindScreen extends StatefulWidget {
  const FindScreen({super.key});
  @override
  State<FindScreen> createState() => _FindScreenState();
}

class _FindScreenState extends State<FindScreen> {
  StreamSubscription<List<ScanResult>>? _scan;

  @override
  void initState() {
    super.initState();
    final s = context.read<GlassesState>();
    if (!s.connected) _scan = s.watchWhileDisconnected(); // advertising RSSI while not connected
  }

  @override
  void dispose() {
    if (_scan != null) { _scan!.cancel(); FlutterBluePlus.stopScan(); }
    super.dispose();
  }

  String _ago(DateTime t) {
    final d = DateTime.now().difference(t);
    if (d.inMinutes < 1) return 'just now';
    if (d.inHours < 1) return '${d.inMinutes} min ago';
    if (d.inDays < 1) return '${d.inHours} h ago';
    return '${d.inDays} d ago';
  }

  @override
  Widget build(BuildContext context) {
    final s = context.watch<GlassesState>();
    final w = s.inRange ? s.warmth : 0.0;
    final label = !s.inRange ? 'Not in range' : w > 0.75 ? 'Hot' : w > 0.5 ? 'Warmer' : w > 0.25 ? 'Cool' : 'Cold';
    final last = s.lastSeen;
    return Scaffold(
      appBar: AppBar(title: const Text('Find my glasses')),
      body: ListView(padding: const EdgeInsets.all(16), children: [
        Text(s.inRange ? '● in range · ${s.rssi?.round()} dBm' : '○ not heard for a while',
            style: TextStyle(color: s.inRange ? Colors.teal : Colors.grey)),
        const SizedBox(height: 24),
        Center(
          child: SizedBox(
            width: 220, height: 220,
            child: Stack(alignment: Alignment.center, children: [
              SizedBox.expand(child: CircularProgressIndicator(value: w, strokeWidth: 18,
                  color: Color.lerp(Colors.lightBlue, Colors.deepOrange, w), backgroundColor: Colors.black12)),
              Column(mainAxisSize: MainAxisSize.min, children: [
                Text(label, style: Theme.of(context).textTheme.headlineMedium),
                Text(s.distanceHint),
              ]),
            ]),
          ),
        ),
        const SizedBox(height: 24),
        Card(
          child: ListTile(
            leading: const Icon(Icons.place_outlined),
            title: Text(s.connected ? 'Connected now' : 'Last seen'),
            subtitle: Text(last == null
                ? 'No disconnect recorded yet'
                : 'Disconnected ${_ago(last.when)}'
                    '${last.lat != null ? '\nPhone was at ${last.lat!.toStringAsFixed(5)}, ${last.lon!.toStringAsFixed(5)}' : '\n(no location permission / fix)'}'),
            isThreeLine: last != null,
            // Open last.lat/lon in a maps app with url_launcher if you like (geo: or https://maps.google.com/?q=lat,lon).
          ),
        ),
        const SizedBox(height: 16),
        FilledButton.icon(
          icon: const Icon(Icons.notifications_active),
          label: const Text('Play sound'),
          onPressed: s.connected ? s.playFindSound : null, // needs the BLE link: connect from the scan screen first
        ),
        TextButton(onPressed: s.connected ? s.stopFindSound : null, child: const Text('Stop')),
        const SizedBox(height: 8),
        const Text('The chime plays at a fixed level even if the volume is at zero. The glasses must be switched on and within Bluetooth range.',
            style: TextStyle(fontSize: 12, color: Colors.grey)),
      ]),
    );
  }
}

app/lib/screens/scan_screen.dart⤢ Expand ⧉ Copy

import 'package:flutter/material.dart';
import 'package:flutter_blue_plus/flutter_blue_plus.dart';
import 'package:provider/provider.dart';

import '../state/glasses_state.dart';
import 'find_screen.dart';

class ScanScreen extends StatelessWidget {
  const ScanScreen({super.key});

  @override
  Widget build(BuildContext context) {
    final s = context.read<GlassesState>();
    return Scaffold(
      appBar: AppBar(title: const Text('Connect your Muse Glasses'), actions: [
        IconButton(icon: const Icon(Icons.travel_explore), tooltip: 'Find my glasses (last seen + hotter/colder)',
            onPressed: () => Navigator.push(context, MaterialPageRoute(builder: (_) => const FindScreen()))),
      ]),
      body: Column(children: [
        const Padding(
          padding: EdgeInsets.all(16),
          child: Text('1. Pair "Muse Glasses" in the phone\'s Bluetooth settings for audio.\n'
              '2. Allow calls / contacts when the phone asks, so calls ring on the glasses.\n'
              '3. Then connect here for controls, call state, EQ, battery and Find my glasses.'),
        ),
        Expanded(
          child: StreamBuilder<List<ScanResult>>(
            stream: s.scan(),
            builder: (_, snap) {
              final r = snap.data ?? const [];
              if (r.isEmpty) return const Center(child: CircularProgressIndicator());
              return ListView(children: [
                for (final x in r)
                  ListTile(
                    leading: const Icon(Icons.headphones),
                    title: Text(x.device.platformName.isEmpty ? 'Muse Glasses' : x.device.platformName),
                    subtitle: Text('RSSI ${x.rssi} dBm'),
                    onTap: () => s.connect(x.device),
                  ),
              ]);
            },
          ),
        ),
      ]),
    );
  }
}

app/lib/main.dart⧉ Copy

import 'package:flutter/material.dart';
import 'package:provider/provider.dart';

import 'ble/glasses_client.dart';
import 'state/glasses_state.dart';
import 'screens/scan_screen.dart';
import 'screens/control_screen.dart';

void main() {
  runApp(
    ChangeNotifierProvider(
      create: (_) => GlassesState(GlassesClient()),
      child: const MuseApp(),
    ),
  );
}

class MuseApp extends StatelessWidget {
  const MuseApp({super.key});

  @override
  Widget build(BuildContext context) {
    return MaterialApp(
      title: 'Muse Glasses',
      theme: ThemeData(colorSchemeSeed: const Color(0xFFC9967A), useMaterial3: true),
      home: Consumer<GlassesState>(
        builder: (_, s, __) => s.connected ? const ControlScreen() : const ScanScreen(),
      ),
    );
  }
}

## 13 GATT table

Characteristic | UUID | Props | Format
Music Glasses service | 9f3c0001-2b6e-4c1a-8f5d-6a7e0b1c2d3e | — | custom
Volume | 9f3c0002-2b6e-4c1a-8f5d-6a7e0b1c2d3e | R/W/N | uint8 0–127
Play state | 9f3c0003-2b6e-4c1a-8f5d-6a7e0b1c2d3e | R/W/N | uint8 0 paused, 1 playing (write = command)
Track | 9f3c0004-2b6e-4c1a-8f5d-6a7e0b1c2d3e | R/N | UTF-8 title␟artist (0x1F separator), ≤ 180 B
EQ preset | 9f3c0005-2b6e-4c1a-8f5d-6a7e0b1c2d3e | R/W/N | uint8 0 Flat, 1 Bass+, 2 Vocal, 3 Treble
Audio link | 9f3c0006-2b6e-4c1a-8f5d-6a7e0b1c2d3e | R/N | uint8 0 off, 1 connected, 2 streaming
Config | 9f3c0007-2b6e-4c1a-8f5d-6a7e0b1c2d3e | W | bit0 invert swipe, bit1 recalibrate
Find chime | 9f3c0008-2b6e-4c1a-8f5d-6a7e0b1c2d3e | W | uint8 seconds to chime (0 = stop). Fixed level, ignores media volume / mute; pauses music; ignored during a call
Call state | 9f3c0009-2b6e-4c1a-8f5d-6a7e0b1c2d3e | R/N | uint8 0 idle, 1 incoming, 2 outgoing, 3 active
Battery Level | 0x180F / 0x2A19 | R/N | uint8 %

Test with nRF Connect while music plays before the app exists.

## 14 Find my glasses

Three tools in the app's Find screen, none of which need a server or an account:

Hotter / colderRSSI meterWhile connected the app polls readRssi() every 500 ms; when not, it scans for the service UUID and uses the advertising RSSI. Smoothed, then shown as cold → hot with a rough distance (BLE RSSI is ±5–10 dB noisy: treat it as a direction hint).

Last seenWhere you lost themOn every disconnect the app stores the time and the phone's location (geolocator) in shared_preferences, on the phone only. The glasses have no GPS, so this is where the phone was when the link dropped.

Play soundChime, even when mutedWrites N seconds to 9f3c0008. The firmware pauses music and writes a G6–C7 blip straight to I²S at a fixed level, bypassing the A2DP volume. "Stop" writes 0.

Limits: the glasses must be switched on and within BLE range (~10–30 m indoors). If the battery is flat or the switch is off there's nothing to hear and only "last seen" helps. On iOS, background BLE scanning is throttled and needs the bluetooth-central background mode; the disconnect location needs "While Using" (or "Always") location permission, so the app saves it when it next runs if the OS suspended it.

## 15 Build order (bench first)

1. Breadboard audio. QT Py + one amp + speaker, pair a phone and play. Add the second amp with the 330 kΩ and confirm stereo.
2. AVRCP. Check play/pause, volume sync and metadata on both iPhone and Android.
3. Touch. Copper pads on a printed pod blank: log raw values, tune thresholds.
4. Calls. Add the SPH0645 on the breadboard (GPIO22), place a call from the phone: check answer / hang up / reject, both directions of audio, mSBC vs CVSD, and the free heap. Then music → call → music transitions.
5. BLE. Test the GATT with nRF Connect while streaming; watch free heap.
6. App. Connect + Now Playing first, then call state, Find (RSSI, last seen, Play sound), EQ and Settings.
7. Power. Cell, charger, switch; measure streaming current and run a full play-time test.
8. Frame integration. The 14 animated steps of this guide.

## 16 Risks & caveats

- Fit: the QT Py (22 × 18 mm) and amp breakouts (19 × 18 mm) don't fit thin wire temples, so v1 accepts clip-on hinge and ear-tip pods.
- Battery life: ~1 h of music or ~45–60 min of calls on 120 mAh (estimates); ~3× with a 350 mAh cell in a longer left pod.
- Call quality: the mic is ~10 cm from the mouth (behind the ear, for looks): lower voice level and more room noise than earbuds. Tune MIC_GAIN; keep the phone's noise reduction on.
- Echo: open-ear speakers leak into the mic. Mitigated by the phone's AEC + firmware half-duplex ducking + moderate call volume; expect some double-talk clipping.
- iOS: HFP calls work, and iOS sends calls to the glasses when they're the selected audio route (it normally picks the last connected HFP device). iOS won't show the Classic link to apps, so the app relies on the GATT call state. Background BLE scanning is throttled, and the last-seen location depends on the location permission. Android behaves more predictably.
- Legacy HFP data API: uses ESP-IDF's internal codec + legacy PCM callbacks; a future core may drop them (then: external-codec callbacks + own CVSD/mSBC).
- Hinge wiring fatigues: pin the hinges or leave silicone loops.
- Open-ear sound: these speakers resonate near 950 Hz — thin bass, some leakage. Keep gain low.
- Touch through paint: non-conductive finish only; isolate the pads from the metal wire temple (Kapton under the pod channel).
- Stack stability: A2DP + BLE is RAM-tight; Wi-Fi is off the table.
- LiPo near the head: protected cell, 100 mA charge, no charging while worn.
- 9 vs 8 cross-frame wires: see the harness section.

## 17 Sources

- Adafruit QT Py ESP32 Pico (#5395) (https://www.adafruit.com/product/5395) · pinouts (https://learn.adafruit.com/adafruit-qt-py-esp32-pico/pinouts)
- MAX98357A breakout (#3006) (https://www.adafruit.com/product/3006) · SD / GAIN pins (https://learn.adafruit.com/adafruit-max98357-i2s-class-d-mono-amp/pinouts)
- Same Sky CMS-151135-18SP-X8 speaker (https://octopart.com/part/same-sky/CMS-151135-18SP-X8)
- Micro-Lipo USB-C charger (#4410) (https://www.adafruit.com/product/4410) · Copper foil tape (#1128) (https://www.adafruit.com/product/1128)
- 401230 120 mAh LiPo (https://www.amazon.com/dp/B0GDXD64XN)
- ESP32-A2DP releases (https://github.com/pschatzmann/ESP32-A2DP/releases) · coexistence (https://github.com/pschatzmann/ESP32-A2DP/wiki/WIFI-and-A2DP-Coexistence) · sink RAM tuning (https://github.com/pschatzmann/ESP32-A2DP/wiki/A2DP-Sink-Optimizations)
- Adafruit SPH0645LM4H I²S mic breakout (#3421) (https://www.adafruit.com/product/3421) · guide (https://learn.adafruit.com/adafruit-i2s-mems-microphone-breakout)
- ESP-IDF 5.5 HFP client API (https://docs.espressif.com/projects/esp-idf/en/v5.5/esp32/api-reference/bluetooth/esp_hf_client.html) · hfp_hf example (https://github.com/espressif/esp-idf/tree/v5.5/examples/bluetooth/bluedroid/classic_bt/hfp_hf)
- geolocator (https://pub.dev/packages/geolocator) · shared_preferences (https://pub.dev/packages/shared_preferences)
- flutter_blue_plus licence (https://pub.dev/packages/flutter_blue_plus/license)
