fogslin/music-glasses/shots/manual_audio.png

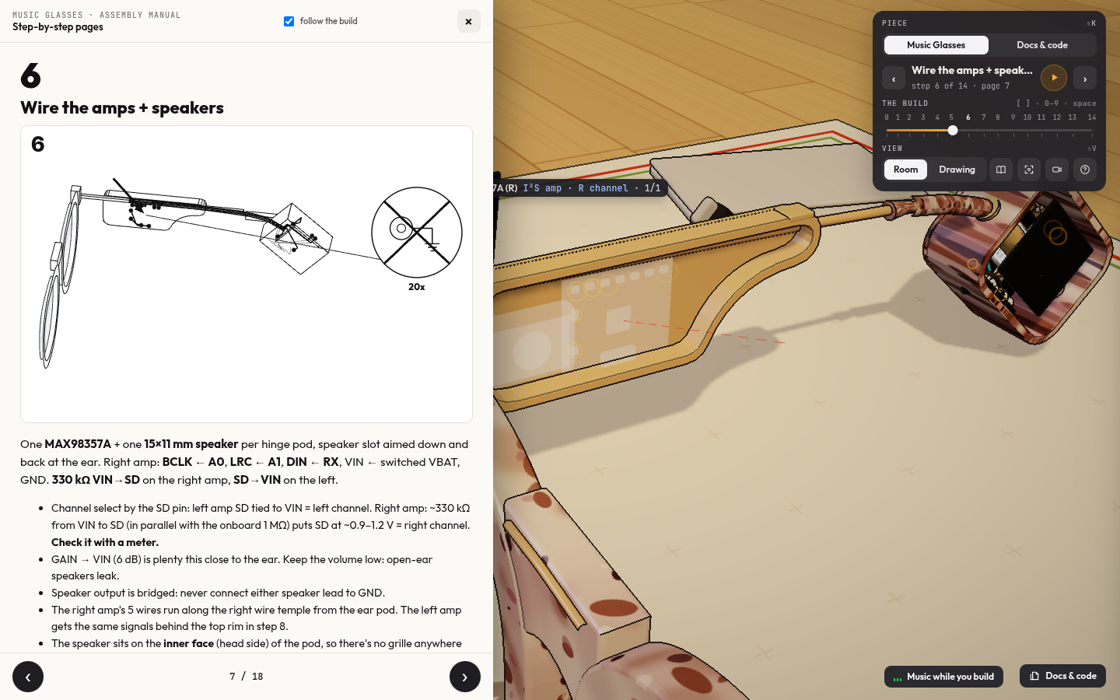
shots/manual_audio.png
